arfrie22/OpenSprinkler-Hardware/KiCad/OpenSprinkler.3d/SUPERCAP_SM3R3703T01.stp

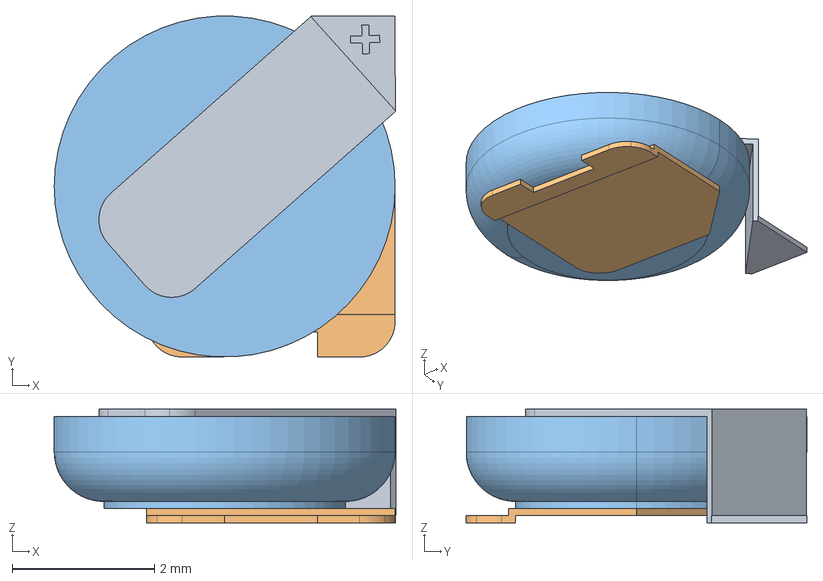
[picture p1: CAD file, 2024-08-12]
KiCad/OpenSprinkler.3d/SUPERCAP_SM3R3703T01.stp
4.81 x 4.80 x 1.60 mm
SUPERCAP_SM3R3703T01
