arfrie22/OpenSprinkler-Hardware/KiCad/RP2350_QFN80.step

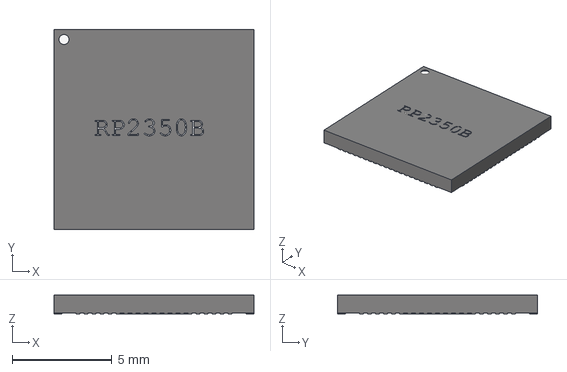
[picture p2: CAD file, 2025-09-04]
KiCad/RP2350_QFN80.step
10.0 x 10.0 x 0.95 mm
