arfrie22/OpenSprinkler-Hardware/KiCad/OpenSprinkler.3d/HRO_TYPE-C-31-M-12.step

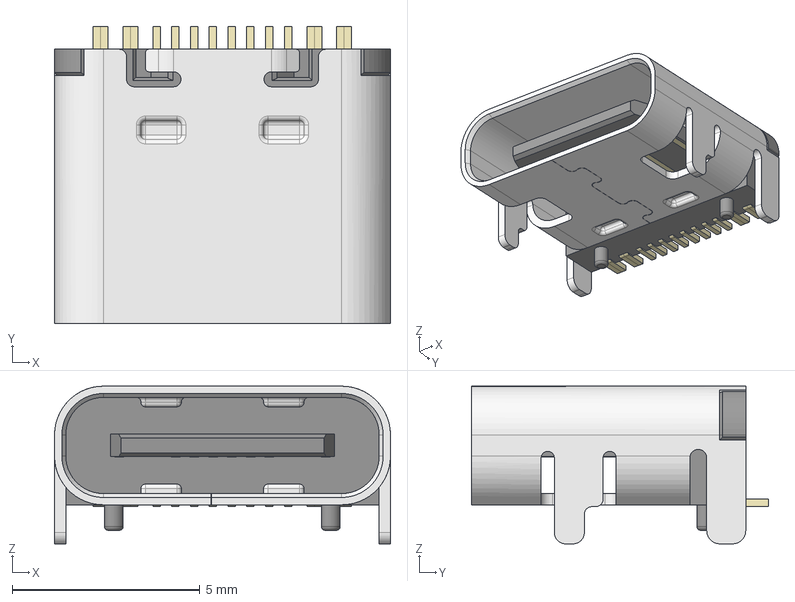
[picture p3: CAD file, 2024-08-12]
KiCad/OpenSprinkler.3d/HRO_TYPE-C-31-M-12.step
8.95 x 7.90 x 4.20 mm
