arfrie22/OpenSprinkler-Hardware/OS/4.0/OpenSprinkler4.0_DC/out/OpenSprinkler4.0_DC.pdf

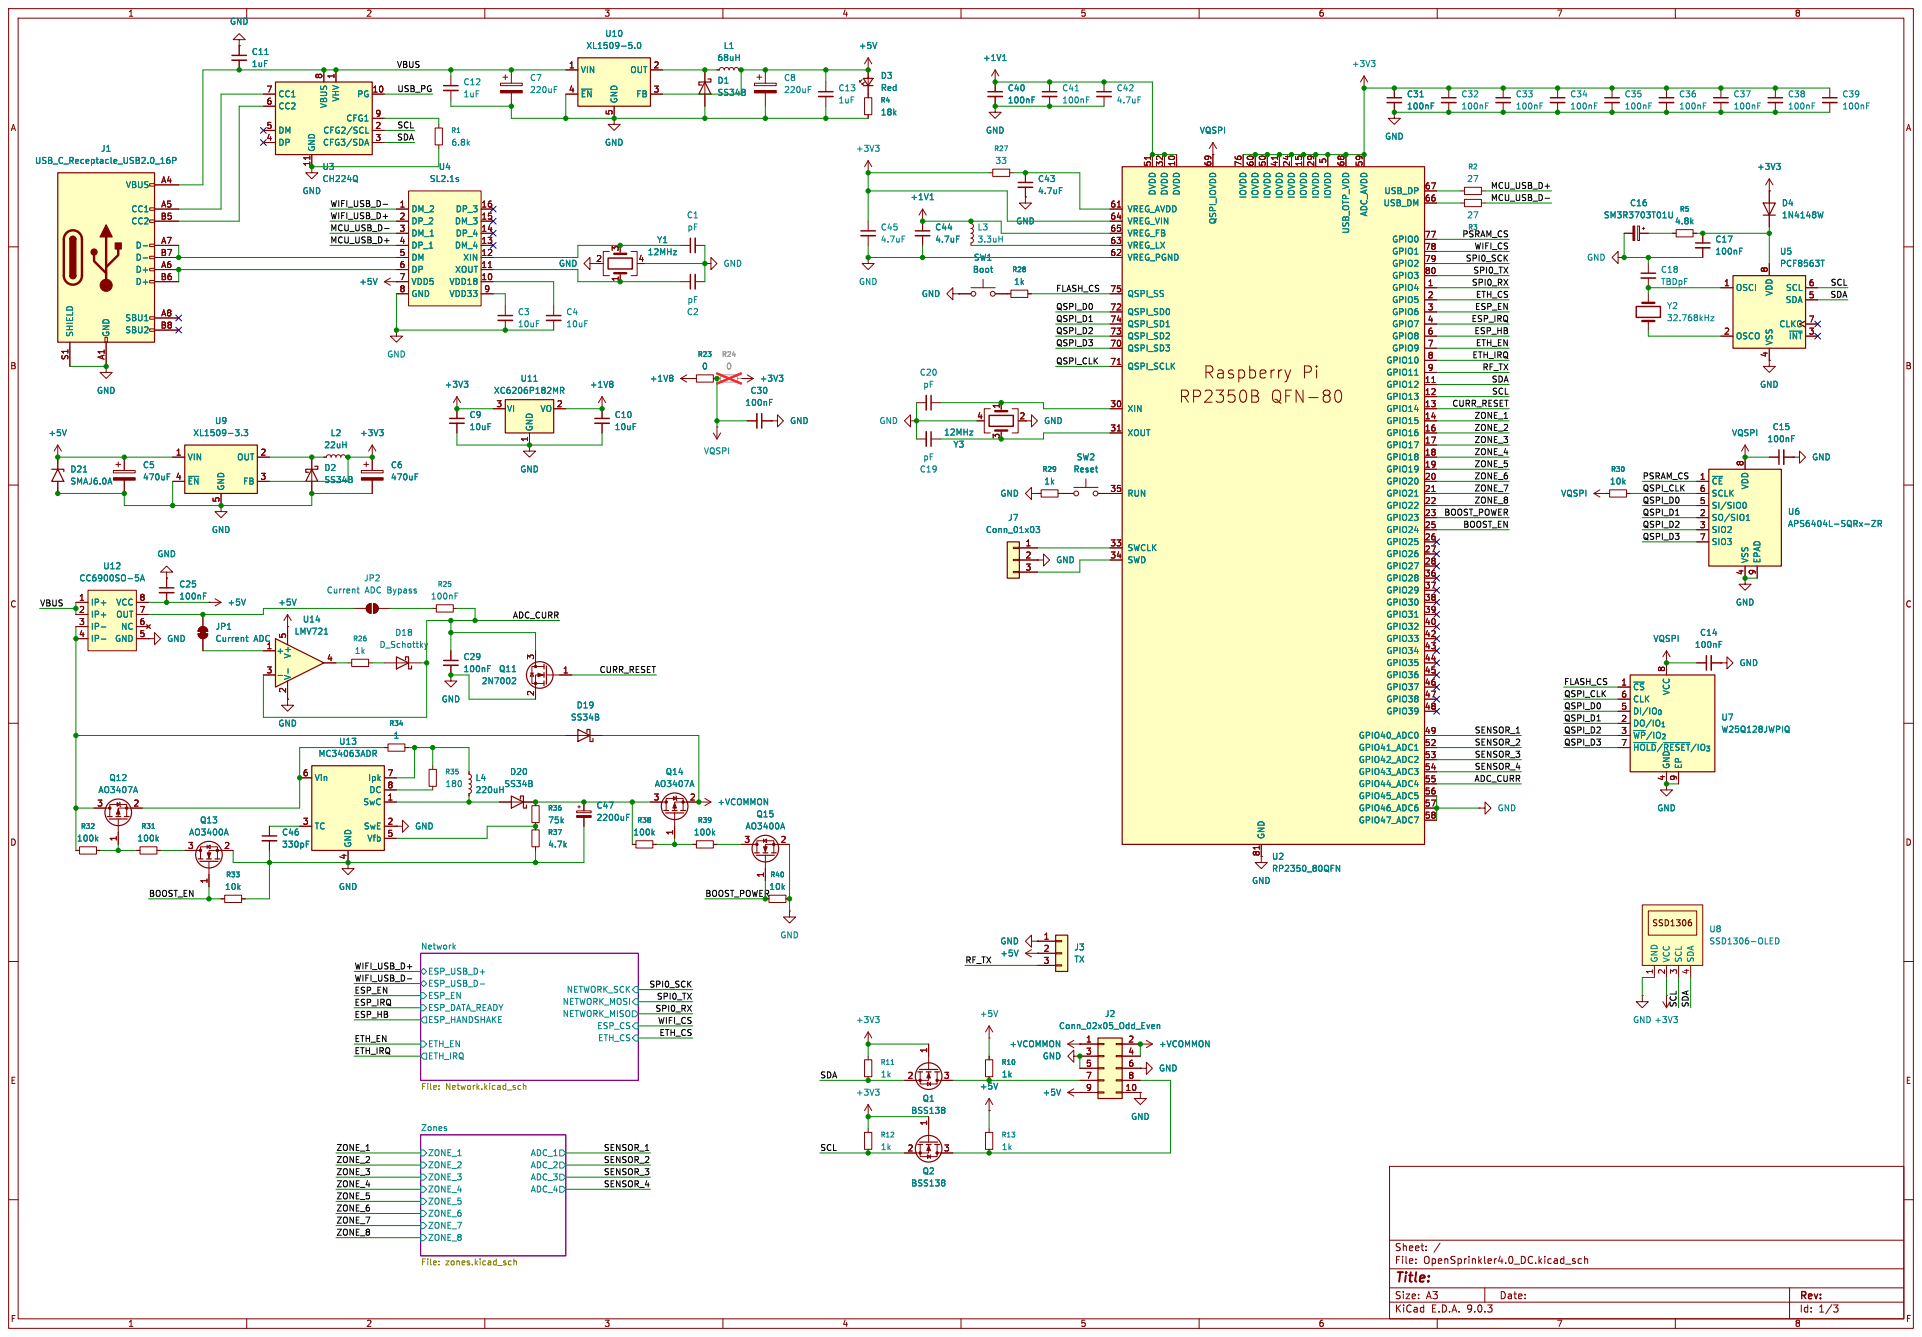
[picture p4: page 1]

1 PG 10 CFG1 9 CFG2/SCL 2 CFG3/SDA 3 GND

Id: 1/3 Title: File: OpenSprinkler4.0_DC.kicad_sch Sheet: / ADC_1 ADC_2 ADC_3 ADC_4 ZONE_1 ZONE_2 ZONE_3 ZONE_4 ZONE_5 ZONE_6 ZONE_7 ZONE_8 Zones File: zones.kicad_sch ESP_HANDSHAKE

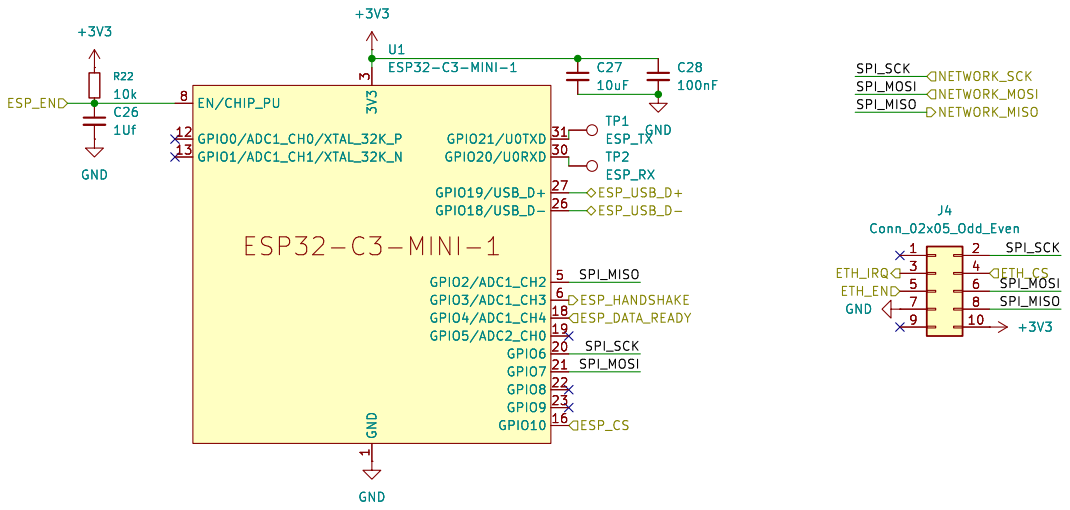
[picture p5: page 2]

Id: 2/3 Title: File: Network.kicad_sch Sheet: /Network/

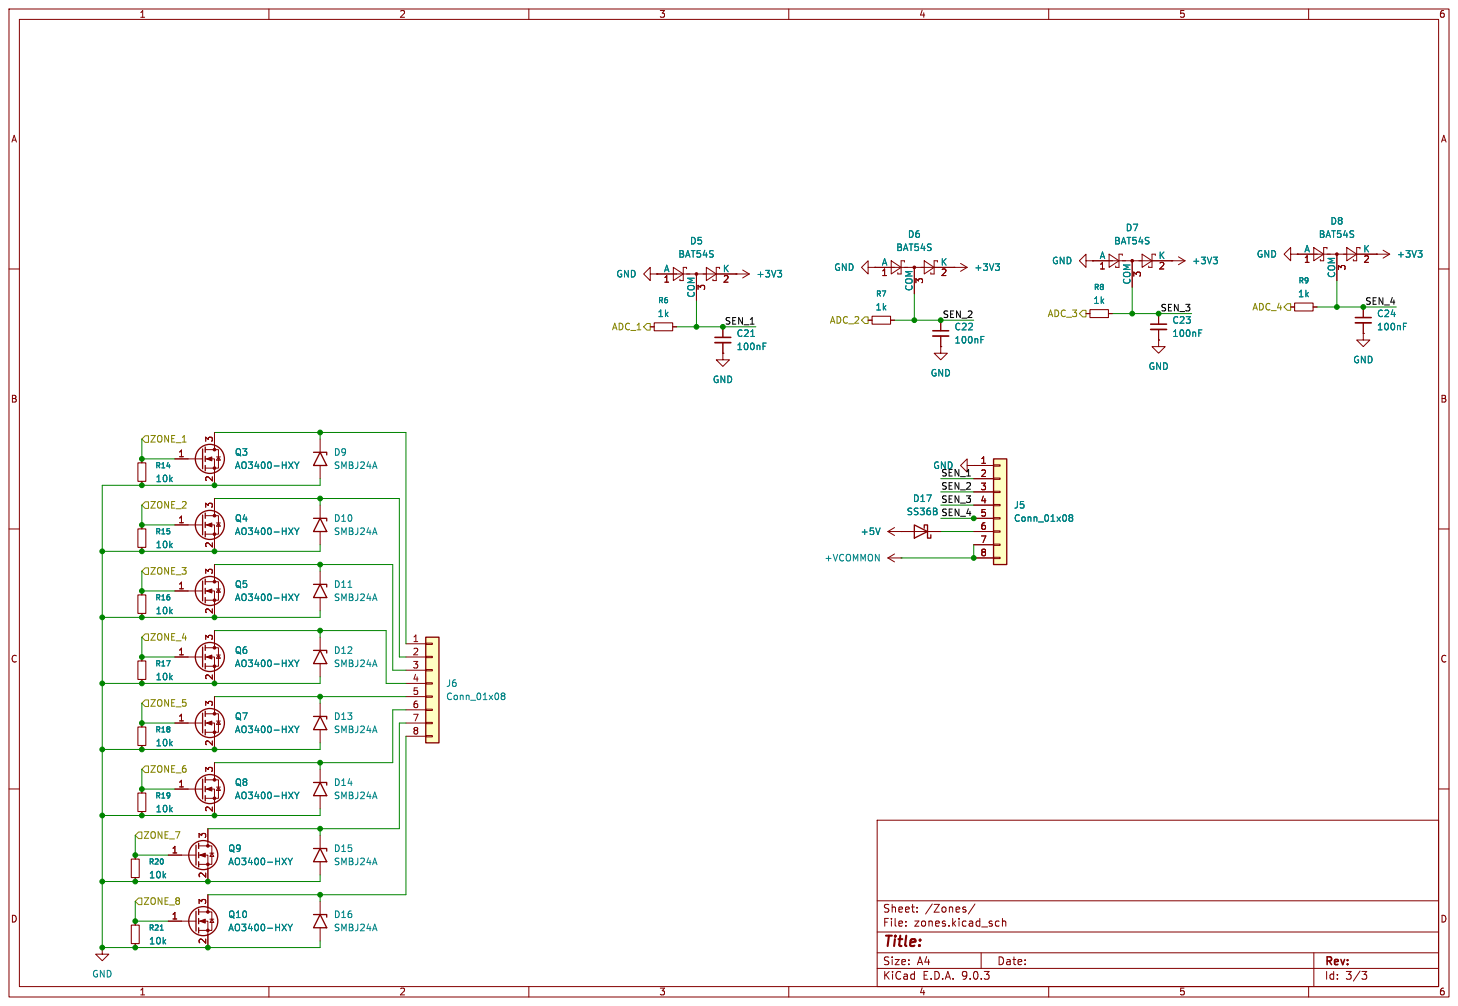
[picture p6: page 3]

Id: 3/3 Title: File: zones.kicad_sch Sheet: /Zones/
