arfrie22/OpenSprinkler-Hardware/OS/4.0/OpenSprinkler4.0_DC/OpenSprinkler4.0_DC.kicad_pcb

## KiCad design OS/4.0/OpenSprinkler4.0_DC/OpenSprinkler4.0_DC.kicad_pcb (2025-09-04)

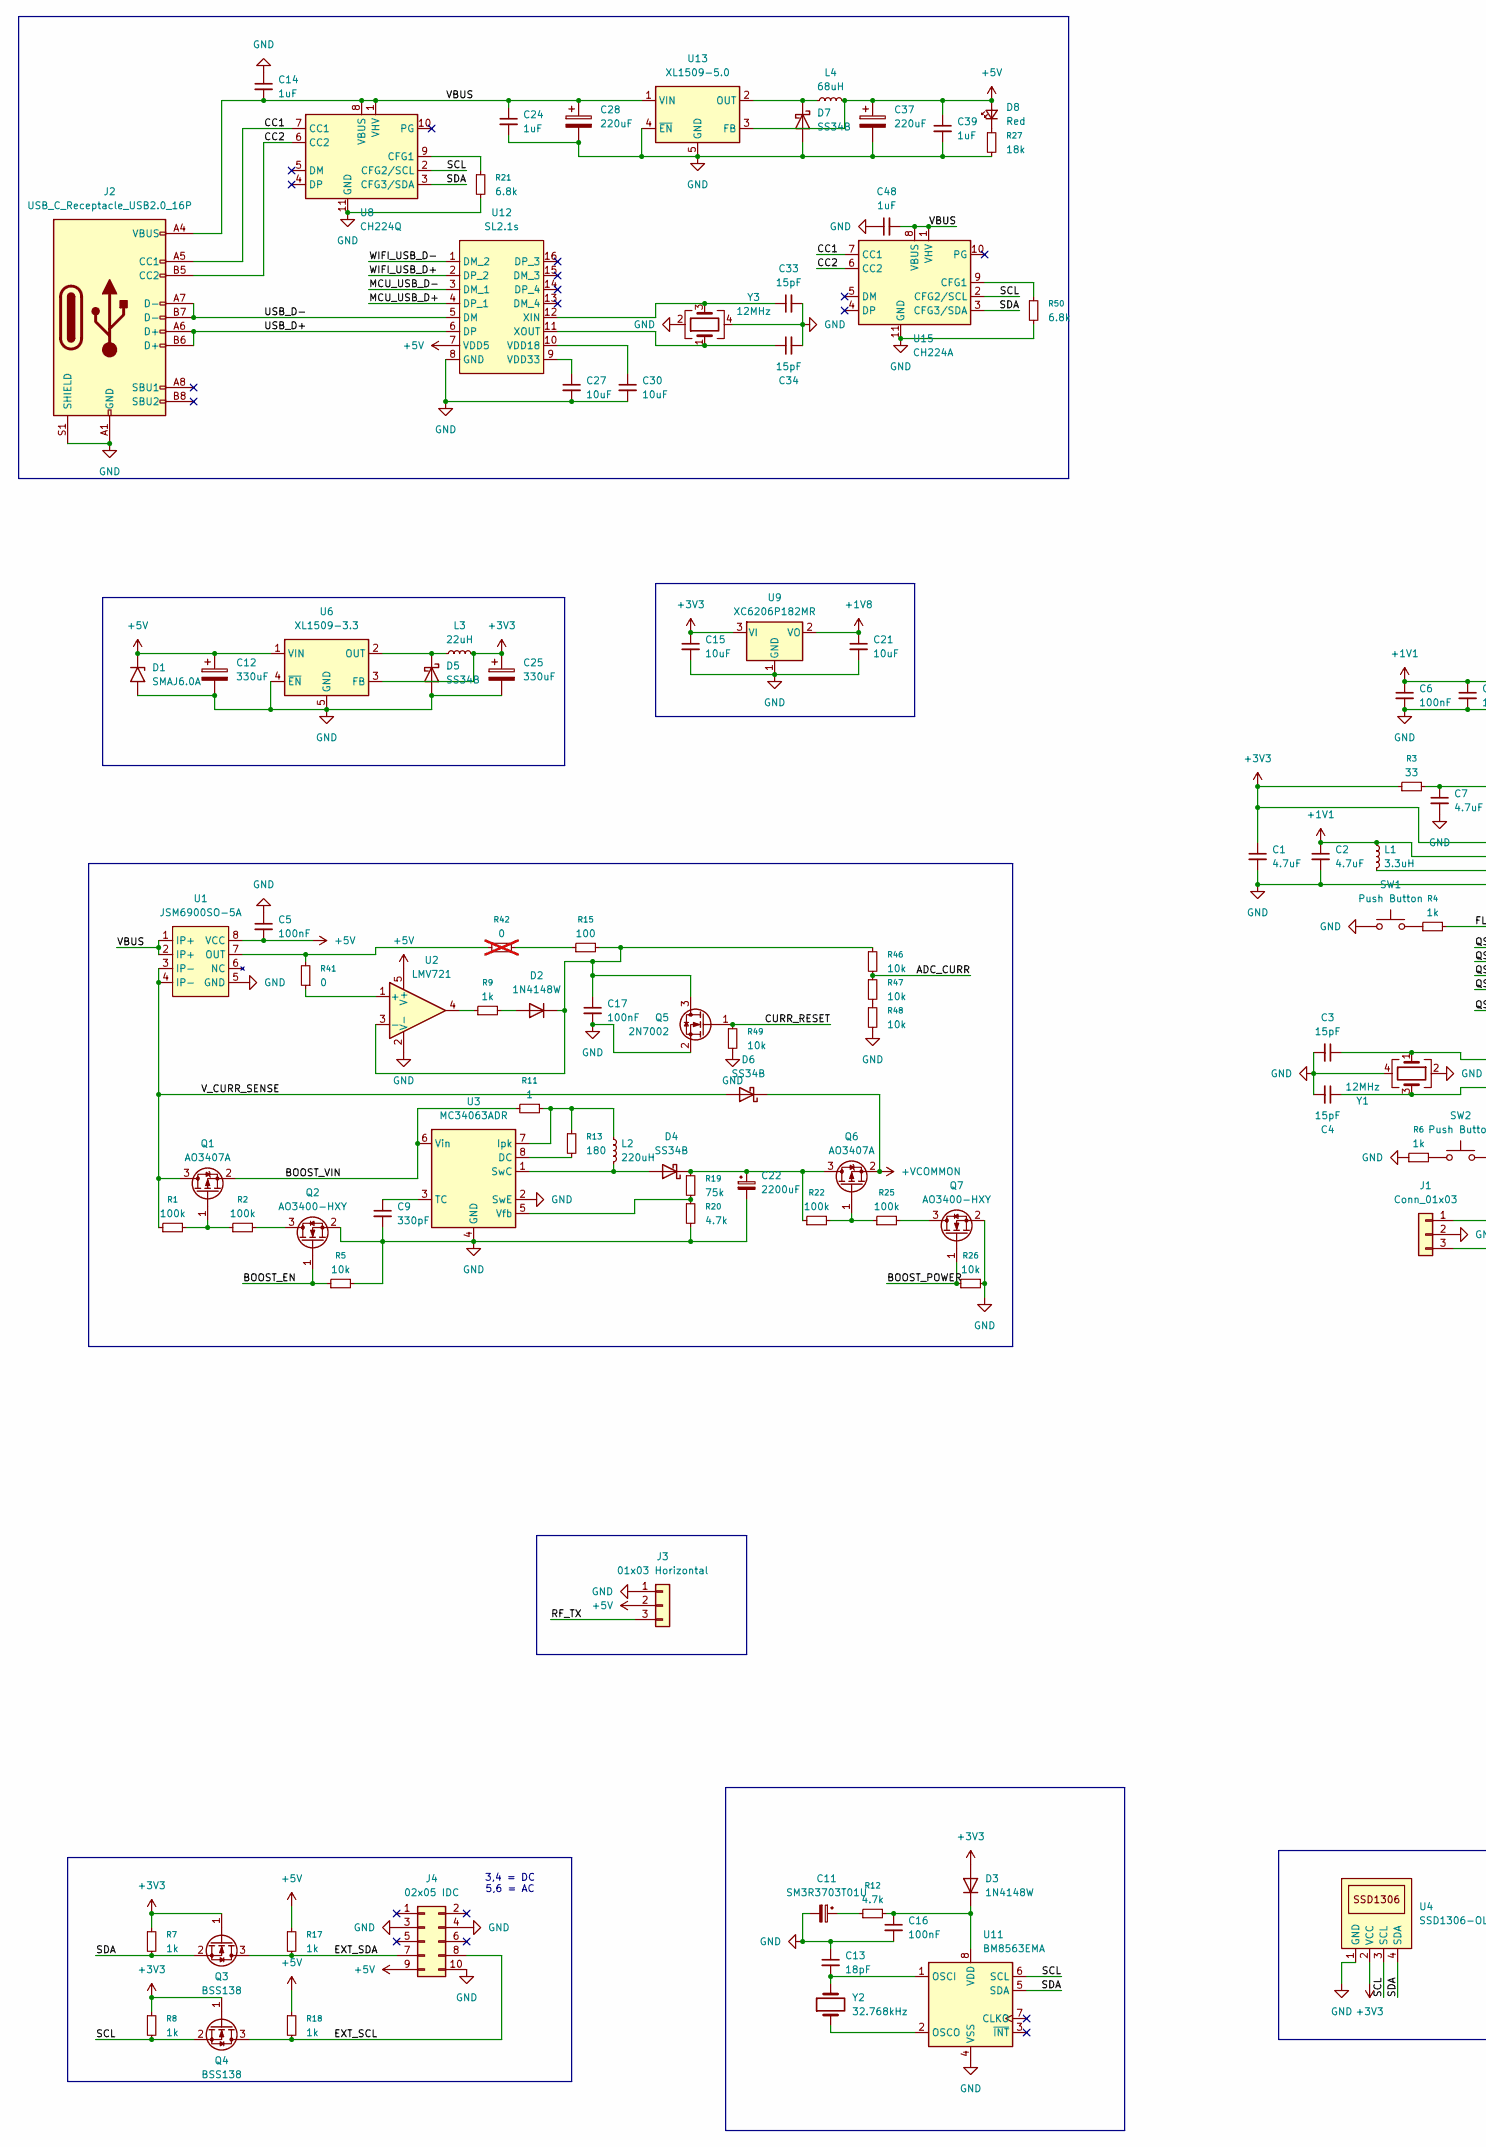
[picture p7: schematic OpenSprinkler4.0_DC.kicad_sch, part in row 1, column 1]

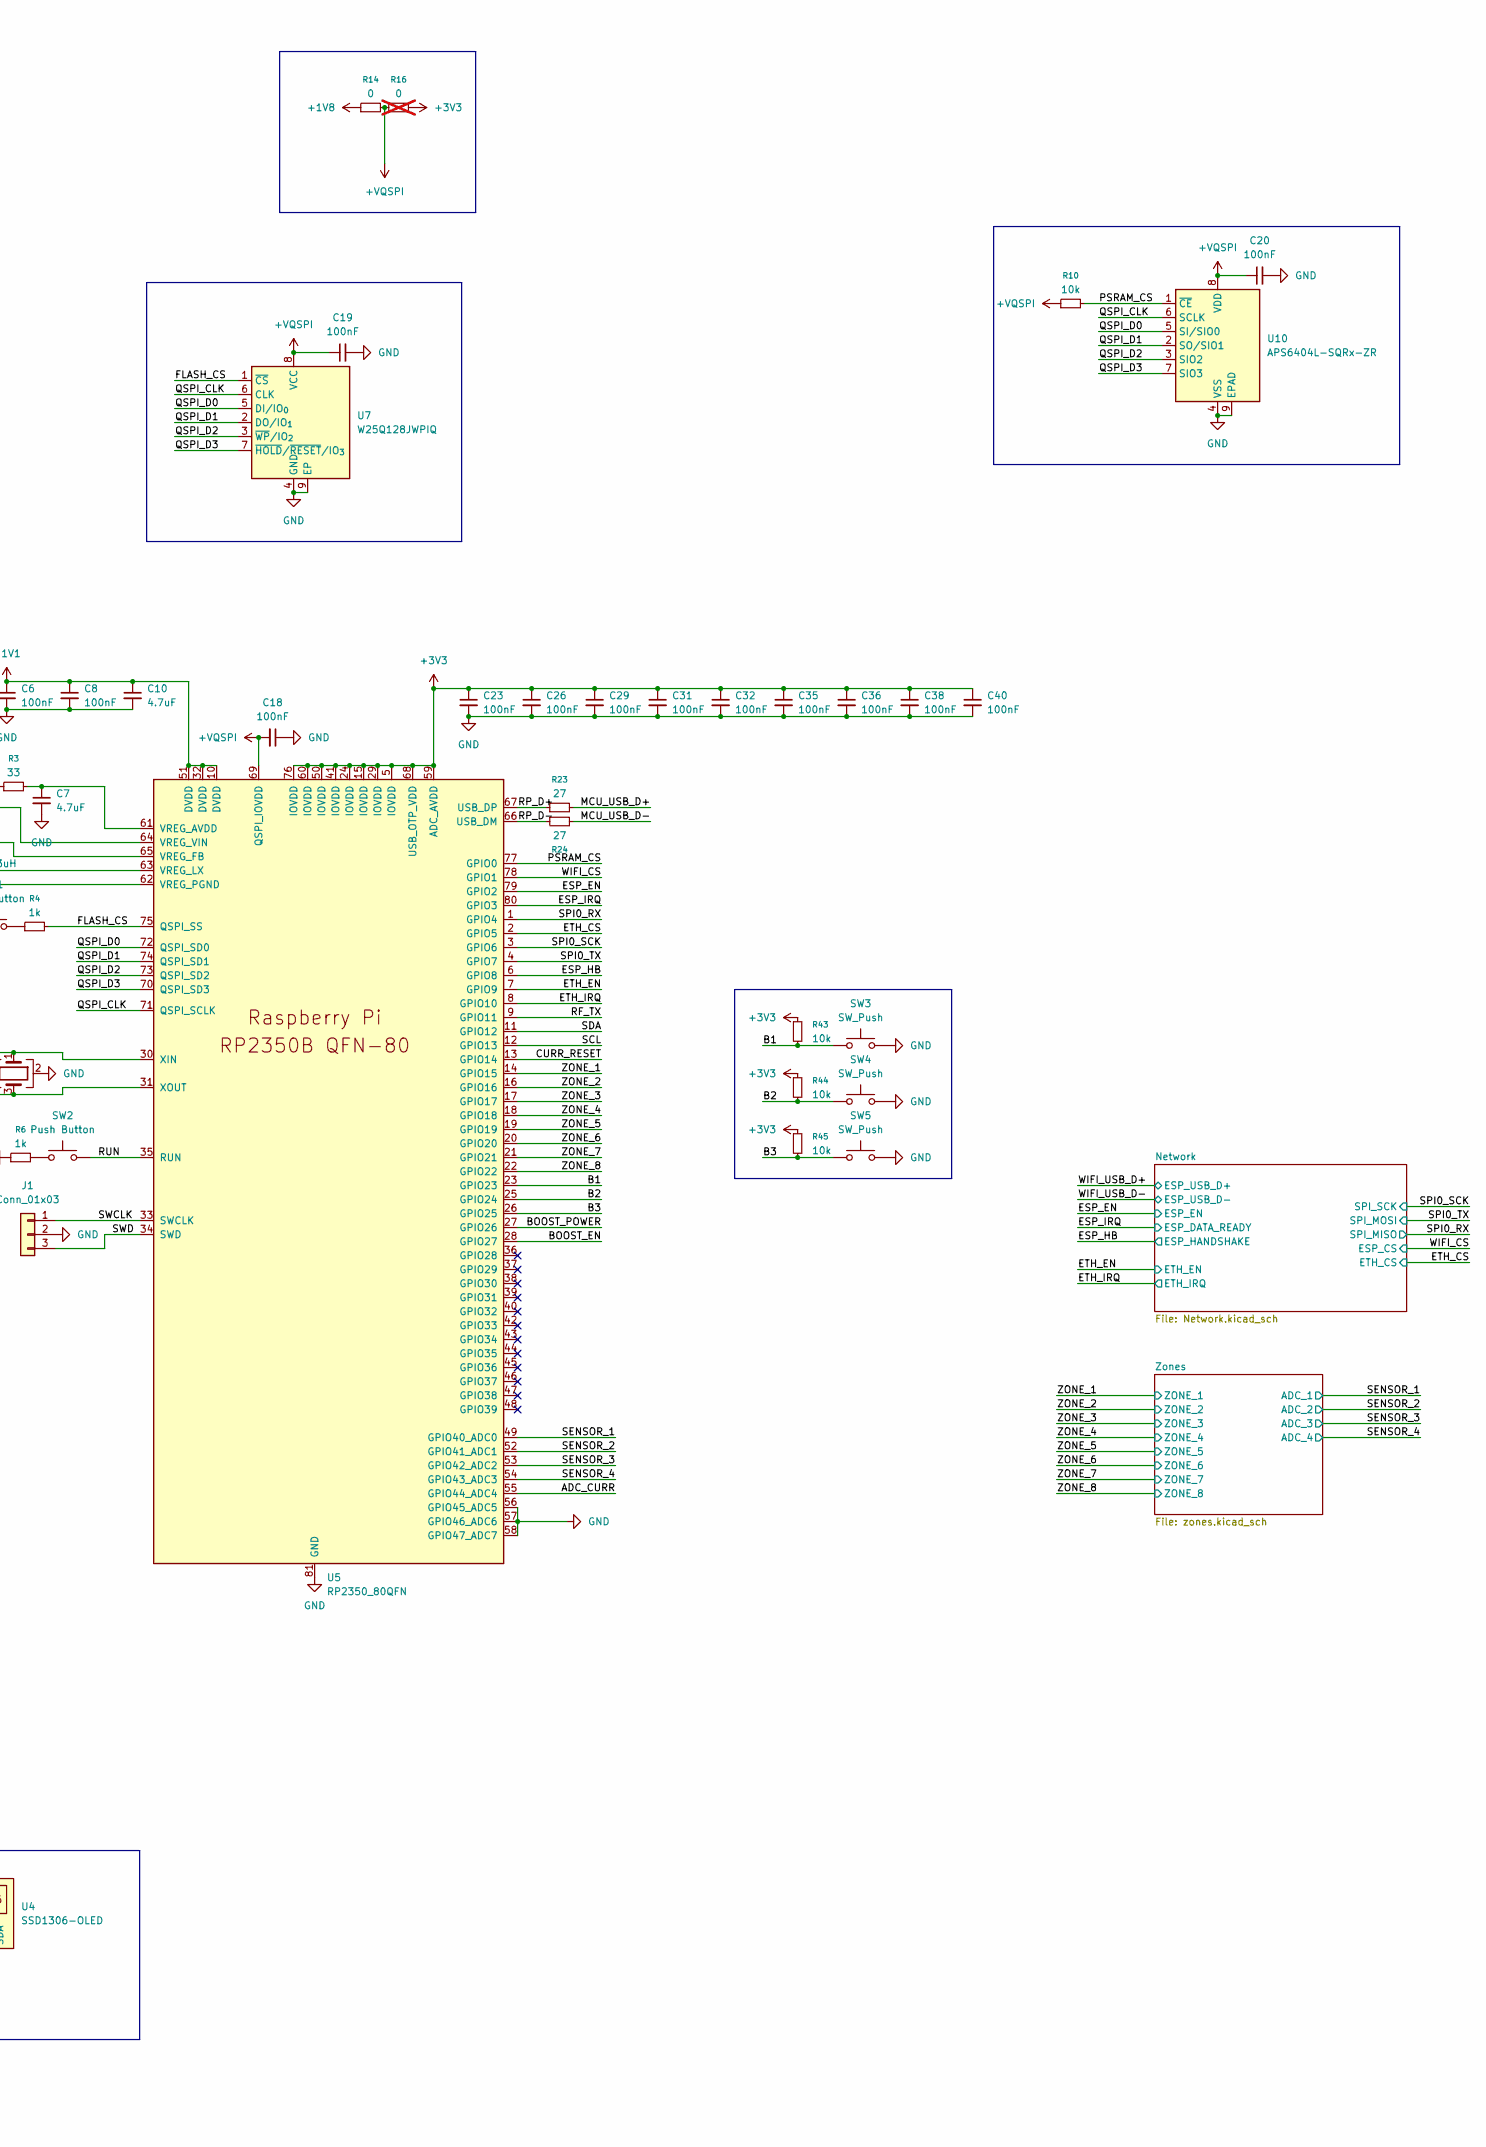
[picture p8: schematic OpenSprinkler4.0_DC.kicad_sch, part in row 1, column 2]

Parts:
C1, C2, C7, C10: 4.7uF; C_0402_1005Metric; LCSC C23733
C3, C4, C33, C34: 15pF; C_0402_1005Metric; LCSC C1548
C5, C6, C8, C16, C17, C18, C19, C20, C23, C26, C29, C31, C32, C35, C36, C38, C40: 100nF; C_0402_1005Metric; LCSC C307331
C9: 330pF; C_0402_1005Metric; LCSC C13533
C11: SM3R3703T01U; SM3R3703T01
C12, C25: 330uF; CP_Radial_D8.0mm_P3.50mm; LCSC C43839
C13: 18pF; C_0402_1005Metric; LCSC C1549
C14, C24, C39, C48: 1uF; C_0603_1608Metric; LCSC C15849
C15, C21, C27, C30: 10uF; C_0603_1608Metric; LCSC C19702
C22: 2200uF; CP_Radial_L20.0mm_D13.0mm_P5.00mm_Horizontal; LCSC C44598
C28, C37: 220uF; CP_Radial_D6.3mm_P2.50mm; LCSC C12450
D1: SMAJ6.0A; D_SMA; LCSC C19077525
D2, D3: 1N4148W; D_SOD-123; LCSC C7420318
D4, D5, D6, D7: SS34B; D_SMB; LCSC C7420366
D8: Red; LED_0603_1608Metric; LCSC C2286
J1: Conn_01x03; JST_XH_B3B-XH-A_1x03_P2.50mm_Vertical; LCSC C144394
J2: USB_C_Receptacle_USB2.0_16P; USB_C_Receptacle_HRO_TYPE-C-31-M-12; LCSC C2927038
J3: 01x03 Horizontal; PinSocket_1x03_P2.54mm_Horizontal; LCSC C2935993
J4: 02x05 IDC; IDC-Header_2x05_P2.54mm_Horizontal; LCSC C9140
L1: 3.3uH; L_Murata_DFE201610P; LCSC C42411119
L2: 220uH; L_Changjiang_FNR8040S; LCSC C168148
L3: 22uH; L_Changjiang_FNR6045S; LCSC C168080
L4: 68uH; L_Changjiang_FNR6045S; LCSC C168091
Q1, Q6: AO3407A; SOT-23; LCSC C3033400
Q2, Q7: AO3400-HXY; SOT-23; LCSC C4748804
Q3, Q4: BSS138; SOT-23; LCSC C7420339
Q5: 2N7002; SOT-23; LCSC C8545
R1, R2, R22, R25: 100k; R_0402_1005Metric; LCSC C25741
R3: 33; R_0402_1005Metric; LCSC C25105
R4, R6, R7, R8, R9, R17, R18: 1k; R_0402_1005Metric; LCSC C11702
R5, R10, R26, R43, R44, R45, R46, R47, R48, R49: 10k; R_0402_1005Metric; LCSC C25744
R11: 1; R_0603_1608Metric; LCSC C22936
R12, R20: 4.7k; R_0402_1005Metric; LCSC C25900
R13: 180; R_0603_1608Metric; LCSC C22828
R14, R41: 0; R_0402_1005Metric; LCSC C17168
R15: 100; R_0402_1005Metric; LCSC C25076
R16, R42: 0; R_0402_1005Metric; LCSC C17168; not fitted
R19: 75k; R_0402_1005Metric; LCSC C25798
R21, R50: 6.8k; R_0402_1005Metric; LCSC C25917
R23, R24: 27; R_0402_1005Metric; LCSC C25100
R27: 18k; R_0402_1005Metric; LCSC C25762
SW1, SW2: Push Button; SW_SPST_SKQG_WithoutStem; LCSC C318884
SW3, SW4, SW5: SW_Push; SW_Tactile_SPST_Angled_PTS645Vx83-2LFS; LCSC C493019
U1: JSM6900SO-5A; SSOP-8_3.9x5.05mm_P1.27mm; LCSC C7496525
U2: LMV721; SOT-23-5; LCSC C20613263
U3: MC34063ADR; SOP-8_3.76x4.96mm_P1.27mm; LCSC C3014308
U4: SSD1306-OLED; JMD0.96D-1
U5: RP2350_80QFN; QFN-80-1EP_10x10mm_P0.4mm_EP3.4x3.4mm; LCSC C42415655
U6: XL1509-3.3; SOIC-8_3.9x4.9mm_P1.27mm; LCSC C2681226
U7: W25Q128JWPIQ; WSON-8-1EP_6x5mm_P1.27mm_EP3.4x4.3mm; LCSC C2689660
U8: CH224Q; Texas_DLH0010A_WSON-10-1EP_2.2x2mm_P0.4mm_EP0.9x1.5mm; LCSC C46061833
U9: XC6206P182MR; SOT-23-3; LCSC C347373
U10: APS6404L-SQRx-ZR; Winbond_USON-8-1EP_3x2mm_P0.5mm_EP0.2x1.6mm; LCSC C43758152
U11: BM8563EMA; SOIC-8_3.9x4.9mm_P1.27mm; LCSC C269878
U12: SL2.1s; SL2.1S; LCSC C2684433
U13: XL1509-5.0; SOIC-8_3.9x4.9mm_P1.27mm; LCSC C2902368
U15: CH224A; SSOP-10-1EP_3.9x4.9mm_P1mm_EP2.1x3.3mm; LCSC C42459160
Y1, Y3: 12MHz; Crystal_SMD_2520-4Pin_2.5x2.0mm; LCSC C7294610
Y2: 32.768kHz; Crystal_SMD_3215-2Pin_3.2x1.5mm; LCSC C32346

Connections:
+1V1: C2.1, C6.1, C8.1, C10.1, L1.1, U5.10 (DVDD), U5.32 (DVDD), U5.51 (DVDD), U5.65 (VREG_FB)
+1V8: C21.1, R14.1, U9.2 (VO)
+3V3: C1.1, C15.1, C23.1, C25.1, C26.1, C29.1, C31.1, C32.1, C35.1, C36.1, C38.1, C40.1, D3.2 (A), L3.2, Q3.1 (G), Q4.1 (G), R3.1, R7.1, R8.1, R16.2, R43.1, R44.1, R45.1, U4.2 (VCC), U5.5 (IOVDD), U5.15 (IOVDD), U5.24 (IOVDD), U5.29 (IOVDD), U5.41 (IOVDD), U5.50 (IOVDD), U5.59 (ADC_AVDD), U5.60 (IOVDD), U5.64 (VREG_VIN), U5.68 (USB_OTP_VDD), U5.76 (IOVDD), U6.3 (FB), U9.3 (VI); also elsewhere on the board
+5V: C5.2, C12.1, C37.1, C39.1, D1.1 (A1), D8.2 (A), J3.2, J4.9, L4.2, R17.1, R18.1, U1.8 (VCC), U2.5 (V+), U6.1 (VIN), U12.7 (VDD5), U13.3 (FB); also elsewhere on the board
+VQSPI: C18.2, C19.1, C20.1, R10.1, R14.2, R16.1, U5.69 (QSPI_IOVDD), U7.8 (VCC), U10.8 (VDD)
/ADC_CURR: R46.2, R47.1, U5.55 (GPIO44_ADC4)
/B1: R43.2, SW3.1, U5.23 (GPIO23)
/B2: R44.2, SW4.1, U5.25 (GPIO24)
/B3: R45.2, SW5.1, U5.26 (GPIO25)
/BOOST_EN: Q2.1 (G), R5.1, U5.28 (GPIO27)
/BOOST_POWER: Q7.1 (G), R26.1, U5.27 (GPIO26)
/BOOST_VIN: Q1.2 (S), R11.2, U3.6 (Vin)
/CC1: J2.A5 (CC1), U8.7 (CC1), U15.7 (CC1)
/CC2: J2.B5 (CC2), U8.6 (CC2), U15.6 (CC2)
/CURR_RESET: Q5.1 (G), R49.1, U5.13 (GPIO14)
/ESP_EN: U5.79 (GPIO2); also elsewhere on the board
/ESP_HB: U5.6 (GPIO8); also elsewhere on the board
/ESP_IRQ: U5.80 (GPIO3); also elsewhere on the board
/ETH_CS: U5.2 (GPIO5); also elsewhere on the board
/ETH_EN: U5.7 (GPIO9); also elsewhere on the board
/ETH_IRQ: U5.8 (GPIO10); also elsewhere on the board
/EXT_SCL: J4.8, Q4.3 (D), R18.2
/EXT_SDA: J4.7, Q3.3 (D), R17.2
/FLASH_CS: R4.2, U5.75 (QSPI_SS), U7.1 (~CS)
/MCU_USB_D+: R23.2, U12.4 (DP_1)
/MCU_USB_D-: R24.2, U12.3 (DM_1)
/PSRAM_CS: R10.2, U5.77 (GPIO0), U10.1 (~CE)
/QSPI_CLK: U5.71 (QSPI_SCLK), U7.6 (CLK), U10.6 (SCLK)
/QSPI_D0: U5.72 (QSPI_SD0), U7.5 (DI/IO_{0}), U10.5 (SI/SIO0)
/QSPI_D1: U5.74 (QSPI_SD1), U7.2 (DO/IO_{1}), U10.2 (SO/SIO1)
/QSPI_D2: U5.73 (QSPI_SD2), U7.3 (~WP/IO_{2}), U10.3 (SIO2)
/QSPI_D3: U5.70 (QSPI_SD3), U7.7 (~HOLD/~RESET/IO_{3}), U10.7 (SIO3)
/RF_TX: J3.3, U5.9 (GPIO11)
/RP_D+: R23.1, U5.67 (USB_DP)
/RP_D-: R24.1, U5.66 (USB_DM)
/RUN: SW2.2, U5.35 (RUN)
/SCL: Q4.2 (S), R8.2, U4.3 (SCL), U5.12 (GPIO13), U8.2 (CFG2/SCL), U11.6 (SCL), U15.2 (CFG2/SCL)
/SDA: Q3.2 (S), R7.2, U4.4 (SDA), U5.11 (GPIO12), U8.3 (CFG3/SDA), U11.5 (SDA), U15.3 (CFG3/SDA)
/SENSOR_1: U5.49 (GPIO40_ADC0); also elsewhere on the board
/SENSOR_2: U5.52 (GPIO41_ADC1); also elsewhere on the board
/SENSOR_3: U5.53 (GPIO42_ADC2); also elsewhere on the board
/SENSOR_4: U5.54 (GPIO43_ADC3); also elsewhere on the board
/SPI0_RX: U5.1 (GPIO4); also elsewhere on the board
/SPI0_SCK: U5.3 (GPIO6); also elsewhere on the board
/SPI0_TX: U5.4 (GPIO7); also elsewhere on the board
/SWCLK: J1.1, U5.33 (SWCLK)
/SWD: J1.3, U5.34 (SWD)
/USB_D+: J2.A6 (D+), J2.B6 (D+), U12.6 (DP)
/USB_D-: J2.A7 (D-), J2.B7 (D-), U12.5 (DM)
/VBUS: C14.2, C24.1, C28.1, C48.2, J2.A4 (VBUS), J2.A9 (VBUS), J2.B4 (VBUS), J2.B9 (VBUS), U1.1 (IP+), U1.2 (IP+), U8.1 (VHV), U8.8 (VBUS), U13.1 (VIN), U15.1 (VHV), U15.8 (VBUS)
/V_CURR_SENSE: D6.2 (A), Q1.3 (D), R1.1, U1.3 (IP-), U1.4 (IP-)
/WIFI_CS: U5.78 (GPIO1); also elsewhere on the board
/WIFI_USB_D+: U12.2 (DP_2); also elsewhere on the board
/WIFI_USB_D-: U12.1 (DM_2); also elsewhere on the board
/ZONE_1: U5.14 (GPIO15); also elsewhere on the board
/ZONE_2: U5.16 (GPIO16); also elsewhere on the board
/ZONE_3: U5.17 (GPIO17); also elsewhere on the board
/ZONE_4: U5.18 (GPIO18); also elsewhere on the board
/ZONE_5: U5.19 (GPIO19); also elsewhere on the board
/ZONE_6: U5.20 (GPIO20); also elsewhere on the board
/ZONE_7: U5.21 (GPIO21); also elsewhere on the board
/ZONE_8: U5.22 (GPIO22); also elsewhere on the board
unnamed: C11.1, R12.1
unnamed: D2.2 (A), R9.2
unnamed: C17.1, D2.1 (K), Q5.3 (D), R15.2, R46.1, U2.3 (-)
unnamed: C16.1, D3.1 (K), R12.2, U11.8 (VDD)
unnamed: D4.2 (A), L2.2, U3.1 (SwC)
unnamed: C22.1, D4.1 (K), Q6.3 (D), R19.1, R22.1
unnamed: D5.1 (K), L3.1, U6.2 (OUT)
unnamed: D7.1 (K), L4.1, U13.2 (OUT)
unnamed: D8.1 (K), R27.1
unnamed: Q1.1 (G), R1.2, R2.1
unnamed: Q2.3 (D), R2.2
unnamed: Q6.1 (G), R22.2, R25.1
unnamed: Q7.3 (D), R25.2
unnamed: R4.1, SW1.2
unnamed: R6.2, SW2.1
unnamed: R9.1, U2.4
unnamed: R15.1, R42.2
unnamed: R47.2, R48.1
unnamed: R41.2, R42.1, U1.7 (OUT)
unnamed: R41.1, U2.1 (+)
unnamed: R13.2, U3.8 (DC)
unnamed: L2.1, R11.1, R13.1, U3.7 (Ipk)
unnamed: C9.1, U3.3 (TC)
unnamed: R19.2, R20.1, U3.5 (Vfb)
unnamed: C7.1, R3.2, U5.61 (VREG_AVDD)
unnamed: L1.2, U5.63 (VREG_LX)
unnamed: C3.1, U5.30 (XIN), Y1.1
unnamed: C4.1, U5.31 (XOUT), Y1.3
unnamed: R21.1, U8.9 (CFG1)
unnamed: C13.2, U11.1 (OSCI), Y2.2
unnamed: U11.2 (OSCO), Y2.1
unnamed: C30.1, U12.10 (VDD18)
unnamed: C27.1, U12.9 (VDD33)
unnamed: C33.1, U12.12 (XIN), Y3.3
unnamed: C34.1, U12.11 (XOUT), Y3.1
unnamed: R50.1, U15.9 (CFG1)

Notes on the sheet:
3,4 = DC 5,6 = AC

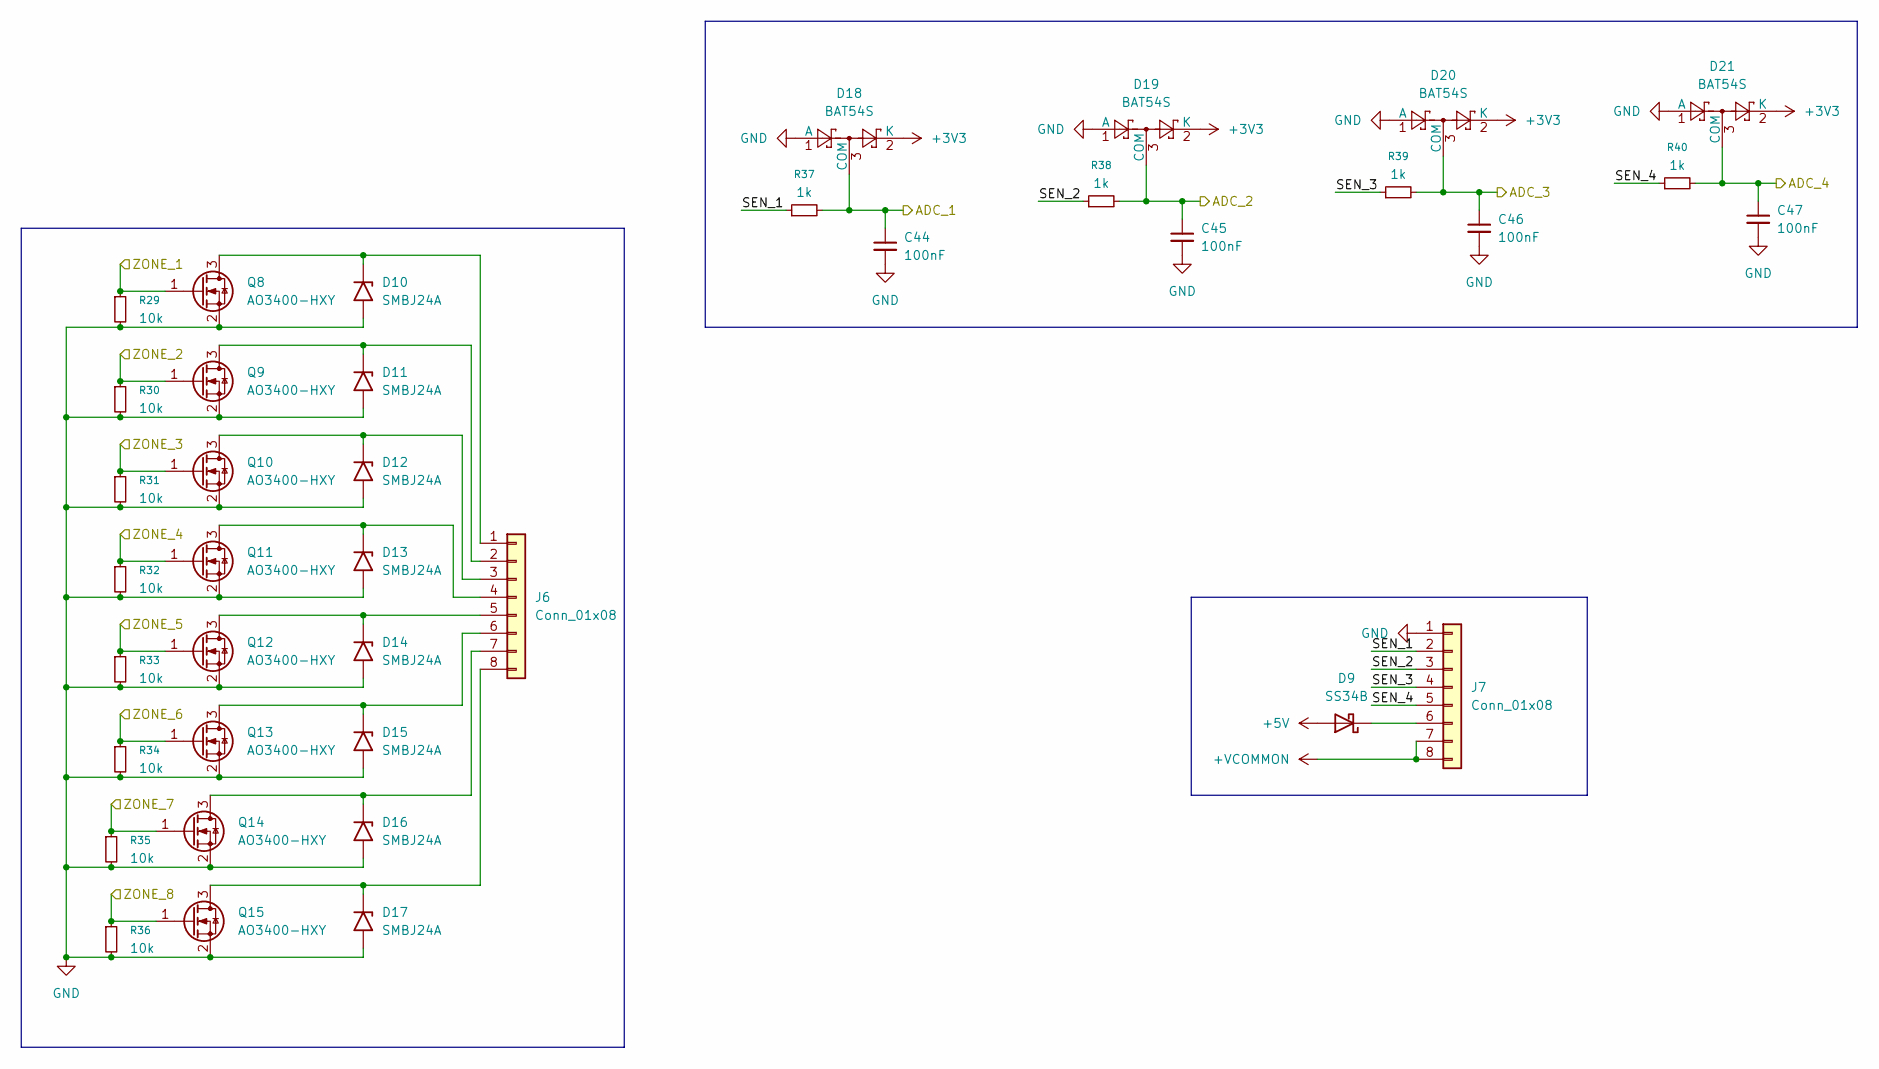
[picture p9: schematic zones.kicad_sch]

Parts:
C44, C45, C46, C47: 100nF; C_0402_1005Metric; LCSC C307331
D9: SS34B; D_SMB; LCSC C7420366
D10, D11, D12, D13, D14, D15, D16, D17: SMBJ24A; D_SMB; LCSC C19077578
D18, D19, D20, D21: BAT54S; SOT-23; LCSC C7420333
J6, J7: Conn_01x08; Samtec_HPM-08-05-x-S_Straight_1x08_Pitch5.08mm; LCSC C31423
Q8, Q9, Q10, Q11, Q12, Q13, Q14, Q15: AO3400-HXY; SOT-23; LCSC C4748804
R29, R30, R31, R32, R33, R34, R35, R36: 10k; R_0402_1005Metric; LCSC C25744
R37, R38, R39, R40: 1k; R_0402_1005Metric; LCSC C11702

Connections:
+3V3: D18.2 (K), D19.2 (K), D20.2 (K), D21.2 (K); also elsewhere on the board
+5V: D9.2 (A); also elsewhere on the board
/SENSOR_1: C44.1, D18.3 (COM), R37.2; also elsewhere on the board
/SENSOR_2: C45.1, D19.3 (COM), R38.2; also elsewhere on the board
/SENSOR_3: C46.1, D20.3 (COM), R39.2; also elsewhere on the board
/SENSOR_4: C47.1, D21.3 (COM), R40.2; also elsewhere on the board
/ZONE_1: Q8.1 (G), R29.1; also elsewhere on the board
/ZONE_2: Q9.1 (G), R30.1; also elsewhere on the board
/ZONE_3: Q10.1 (G), R31.1; also elsewhere on the board
/ZONE_4: Q11.1 (G), R32.1; also elsewhere on the board
/ZONE_5: Q12.1 (G), R33.1; also elsewhere on the board
/ZONE_6: Q13.1 (G), R34.1; also elsewhere on the board
/ZONE_7: Q14.1 (G), R35.1; also elsewhere on the board
/ZONE_8: Q15.1 (G), R36.1; also elsewhere on the board
/Zones/SEN_1: J7.2, R37.1
/Zones/SEN_2: J7.3, R38.1
/Zones/SEN_3: J7.4, R39.1
/Zones/SEN_4: J7.5, R40.1
unnamed: D9.1 (K), J7.6
unnamed: D10.1 (A1), J6.1, Q8.3 (D)
unnamed: D11.1 (A1), J6.2, Q9.3 (D)
unnamed: D12.1 (A1), J6.3, Q10.3 (D)
unnamed: D13.1 (A1), J6.4, Q11.3 (D)
unnamed: D14.1 (A1), J6.5, Q12.3 (D)
unnamed: D15.1 (A1), J6.6, Q13.3 (D)
unnamed: D16.1 (A1), J6.7, Q14.3 (D)
unnamed: D17.1 (A1), J6.8, Q15.3 (D)

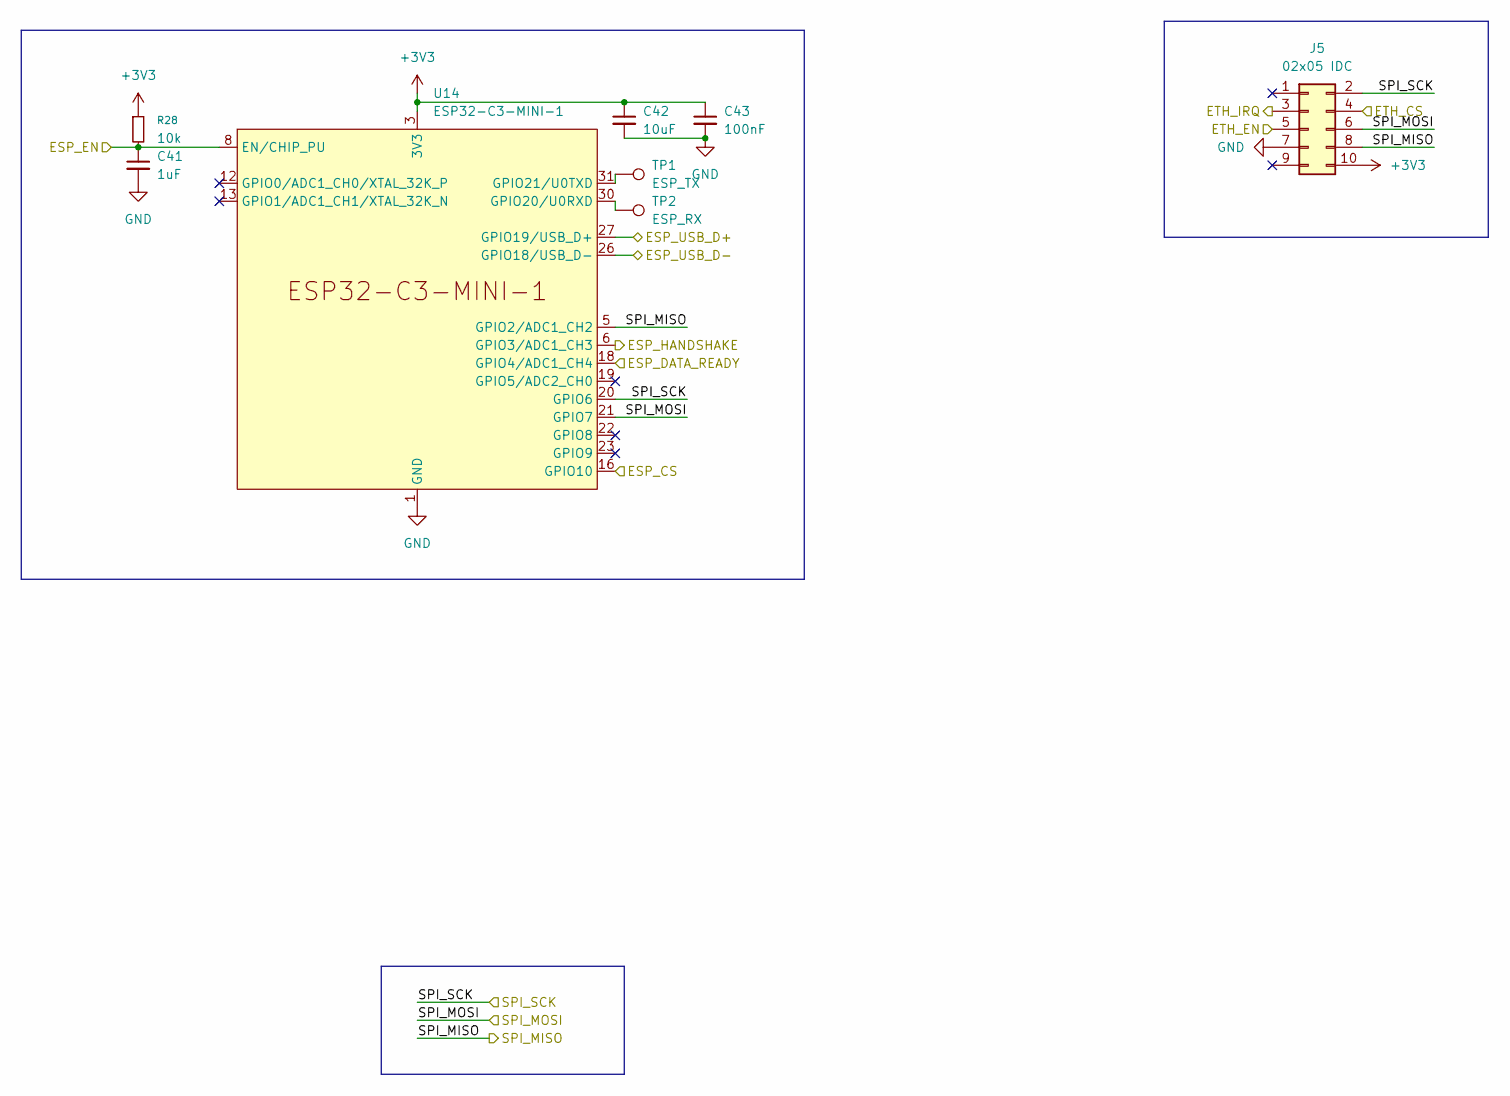
[picture p10: schematic Network.kicad_sch]

Parts:
C41: 1uF; C_0603_1608Metric; LCSC C15849
C42: 10uF; C_0603_1608Metric; LCSC C19702
C43: 100nF; C_0402_1005Metric; LCSC C307331
J5: 02x05 IDC; IDC-Header_2x05_P2.54mm_Horizontal; LCSC C9140
R28: 10k; R_0402_1005Metric; LCSC C25744
TP1: ESP_TX; TestPoint_Pad_D1.5mm
TP2: ESP_RX; TestPoint_Pad_D1.5mm
U14: ESP32-C3-MINI-1; LCSC C41349510

Connections:
+3V3: C42.1, C43.1, J5.10, R28.1, U14.3 (3V3); also elsewhere on the board
/ESP_EN: C41.1, R28.2, U14.8 (EN/CHIP_PU); also elsewhere on the board
/ESP_HB: U14.6 (GPIO3/ADC1_CH3); also elsewhere on the board
/ESP_IRQ: U14.18 (GPIO4/ADC1_CH4); also elsewhere on the board
/ETH_CS: J5.4; also elsewhere on the board
/ETH_EN: J5.5; also elsewhere on the board
/ETH_IRQ: J5.3; also elsewhere on the board
/SPI0_RX: J5.8, U14.5 (GPIO2/ADC1_CH2); also elsewhere on the board
/SPI0_SCK: J5.2, U14.20 (GPIO6); also elsewhere on the board
/SPI0_TX: J5.6, U14.21 (GPIO7); also elsewhere on the board
/WIFI_CS: U14.16 (GPIO10); also elsewhere on the board
/WIFI_USB_D+: U14.27 (GPIO19/USB_D+); also elsewhere on the board
/WIFI_USB_D-: U14.26 (GPIO18/USB_D-); also elsewhere on the board
unnamed: TP2.1, U14.30 (GPIO20/U0RXD)
unnamed: TP1.1, U14.31 (GPIO21/U0TXD)

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
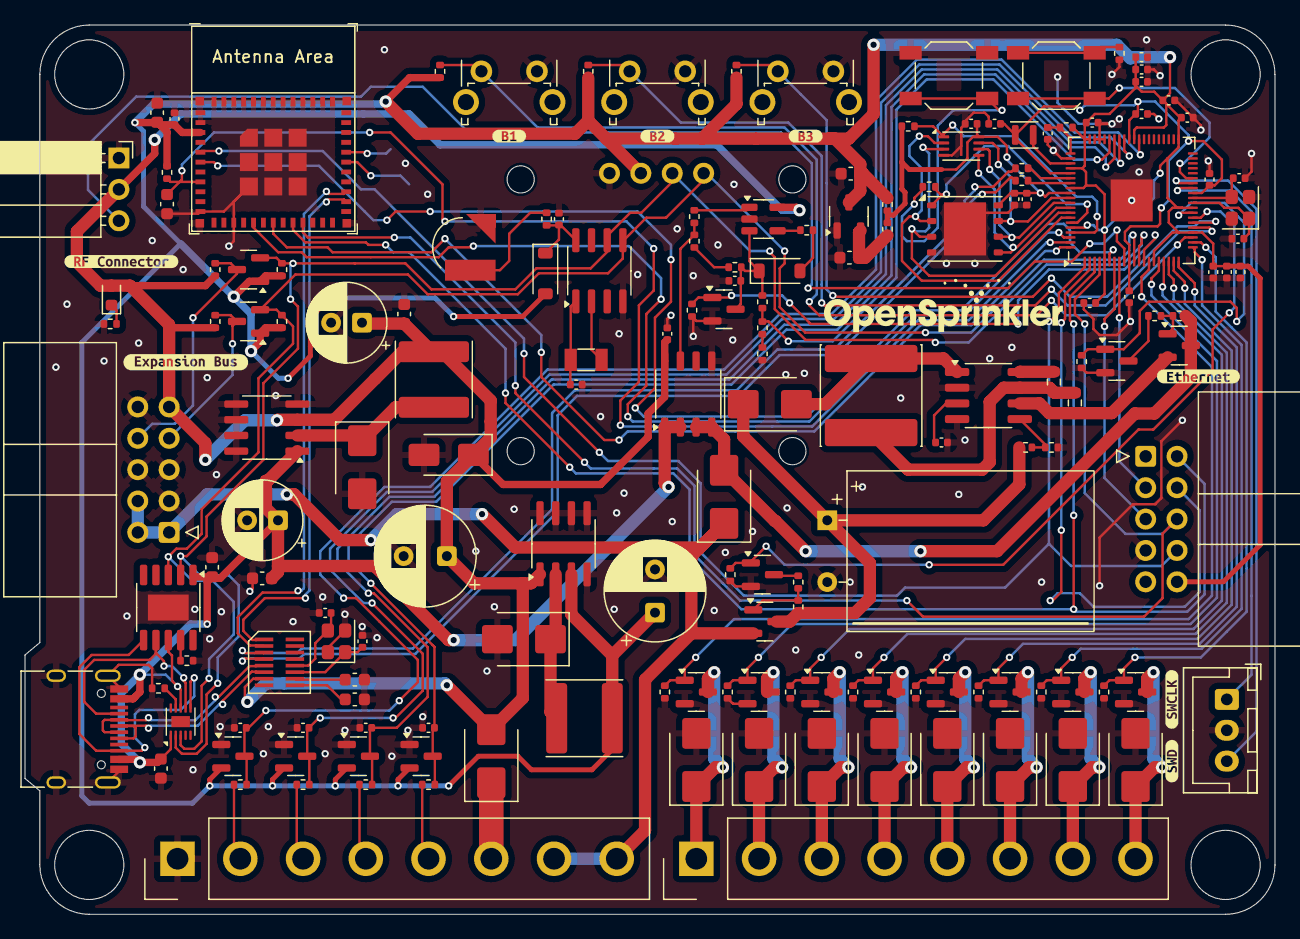
[picture p11: board OpenSprinkler4.0_DC.kicad_pcb from above]

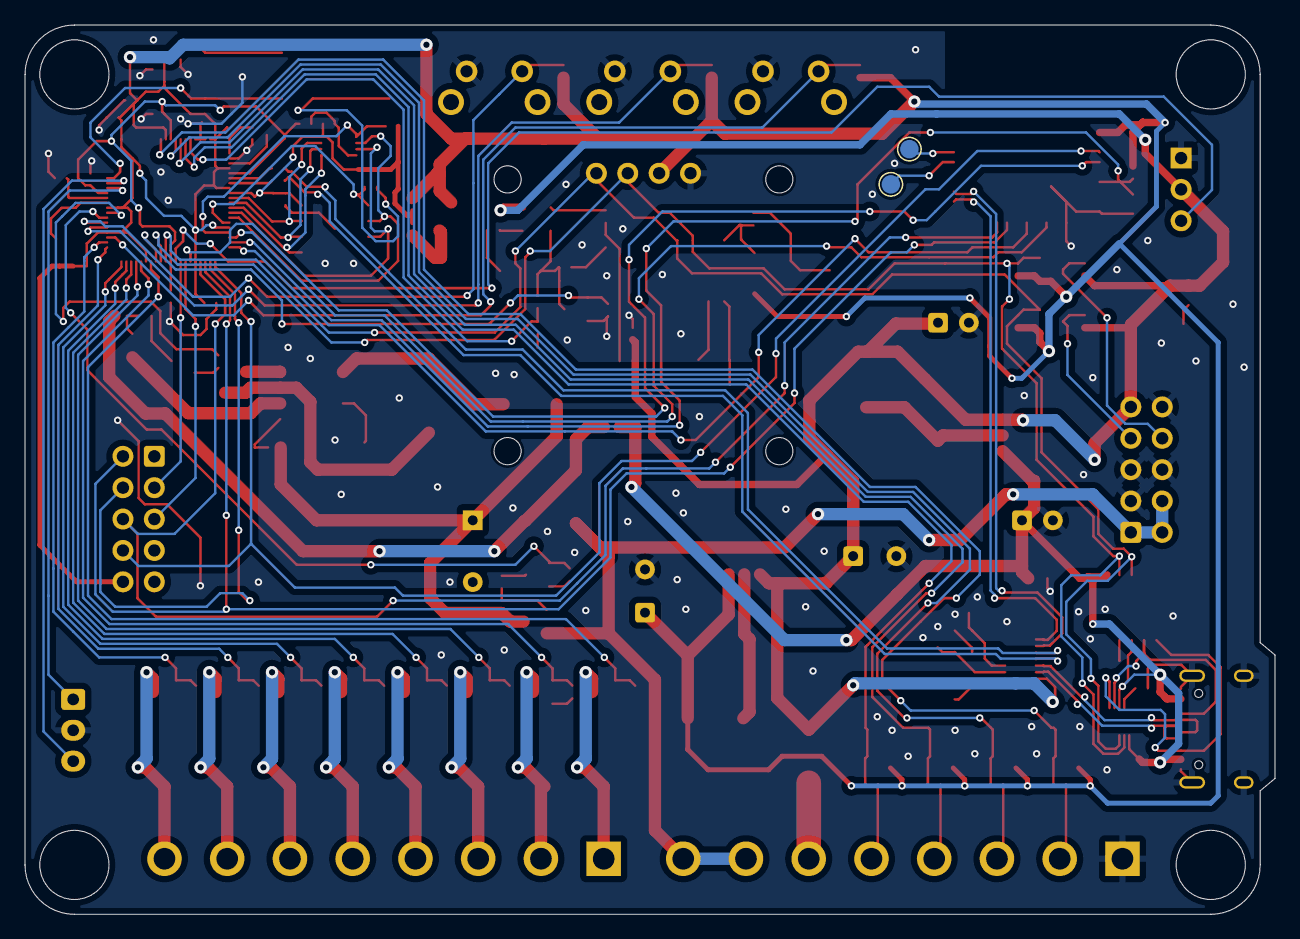
[picture p12: board OpenSprinkler4.0_DC.kicad_pcb from below]

Board: 2 copper layers, 101.2 x 72.0 mm, 178 parts (2 on the bottom side), 115 nets.

Other parts of the board:
kibuzzard-688CCB3A: G***; kibuzzard-688CCB3A
kibuzzard-688CCB7A: G***; kibuzzard-688CCB7A
kibuzzard-688CCB16: G***; kibuzzard-688CCB16
kibuzzard-688CCB53: G***; kibuzzard-688CCB53
kibuzzard-688CCBAC: G***; kibuzzard-688CCBAC
kibuzzard-688CCBBF: G***; kibuzzard-688CCBBF
kibuzzard-688CCBE1: G***; kibuzzard-688CCBE1
kibuzzard-688CCBE6: G***; kibuzzard-688CCBE6
