arfrie22/OpenSprinkler-Hardware/OS/4.0/OpenSprinkler4.0/OpenSprinkler4.0.kicad_pcb

## KiCad design OS/4.0/OpenSprinkler4.0/OpenSprinkler4.0.kicad_pcb (2024-08-12)

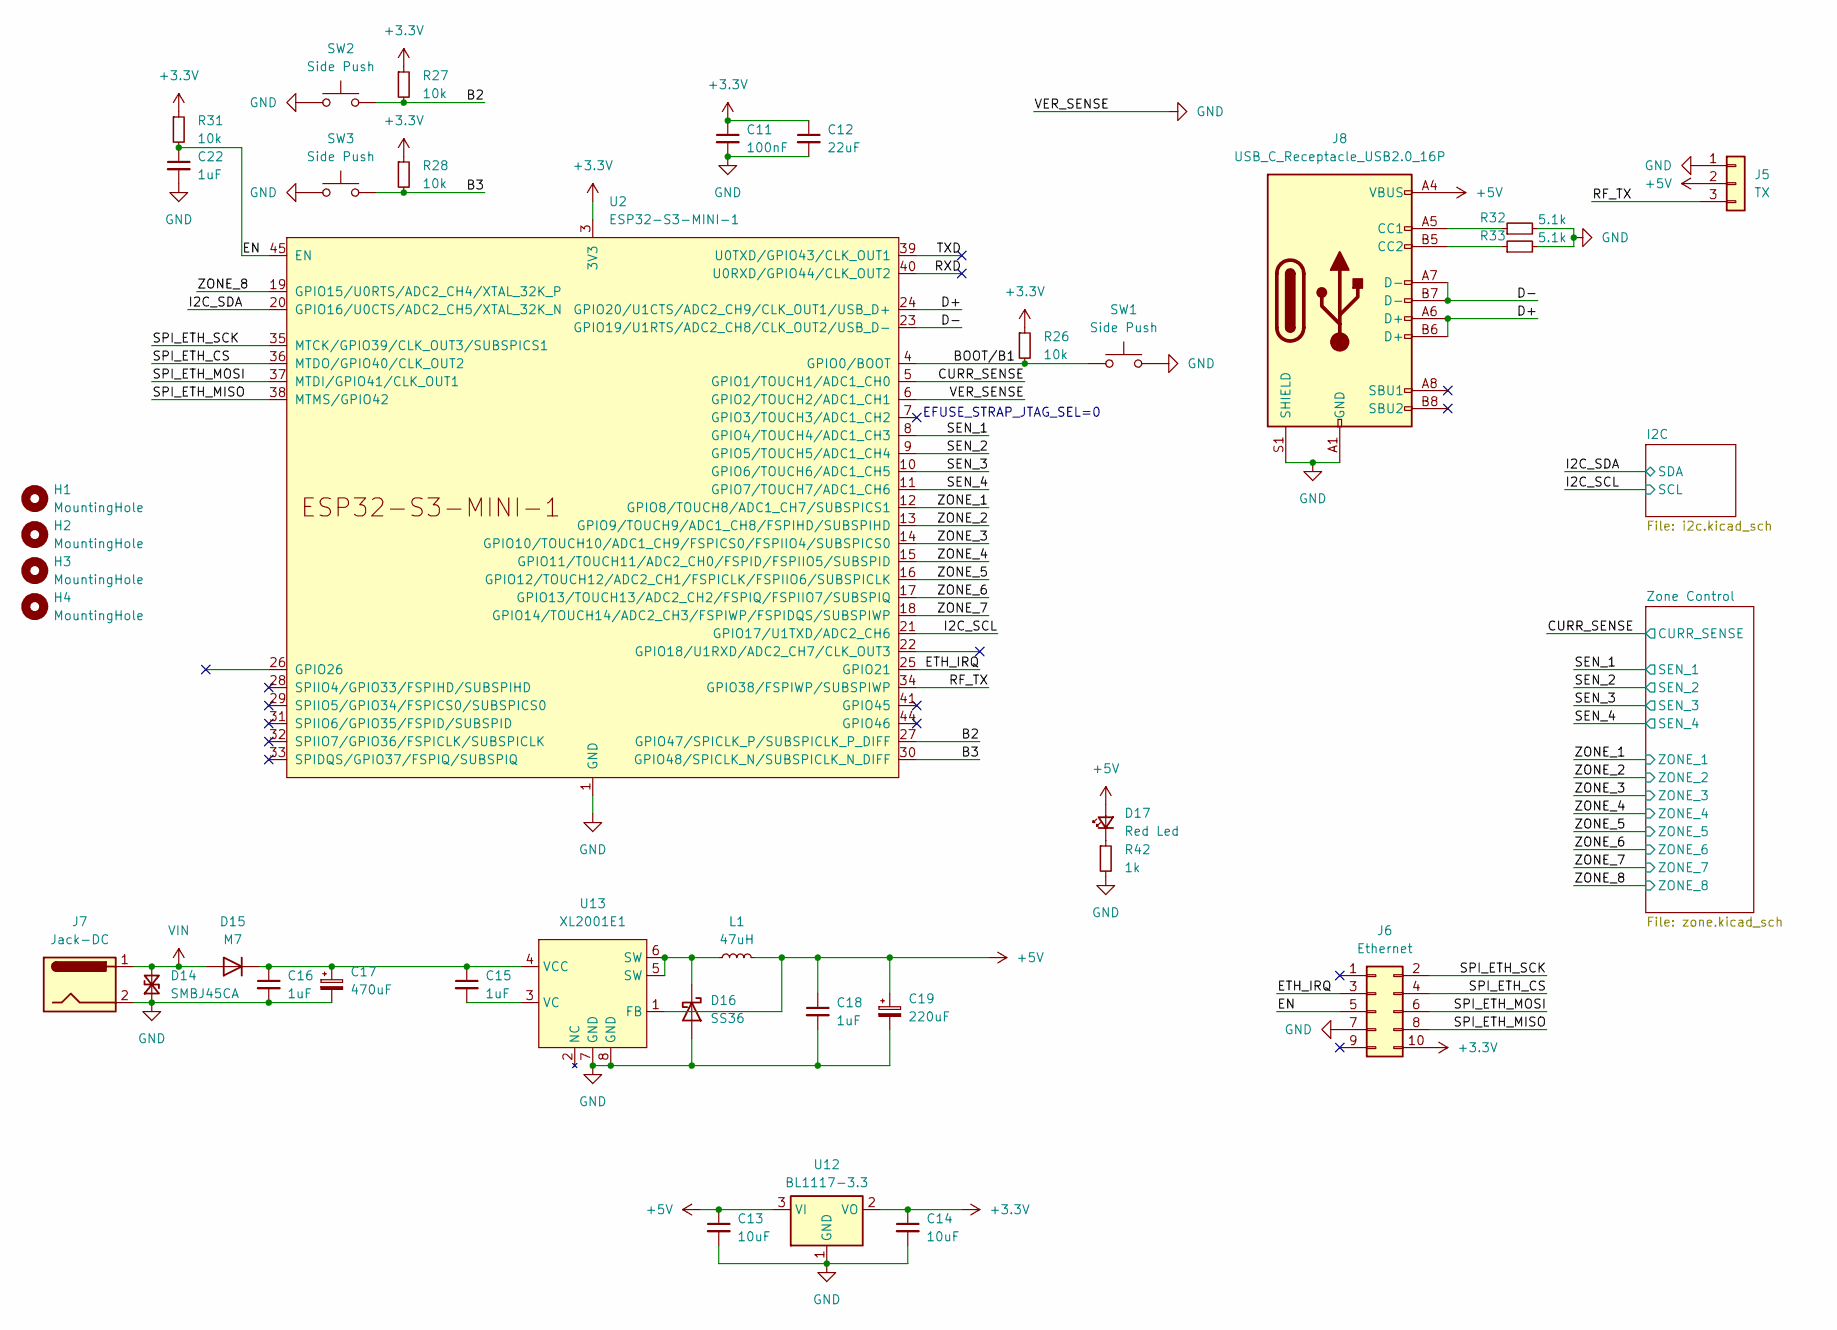
[picture p13: schematic OpenSprinkler4.0.kicad_sch]

Parts:
C11: 100nF; C_0603_1608Metric_Pad1.08x0.95mm_HandSolder; JLCPCB Part # C14663
C12: 22uF; C_0805_2012Metric_Pad1.18x1.45mm_HandSolder; JLCPCB Part # C45783
C13, C14: 10uF; C_0603_1608Metric_Pad1.08x0.95mm_HandSolder; JLCPCB Part # C96446
C15, C16, C18, C22: 1uF; C_0603_1608Metric_Pad1.08x0.95mm_HandSolder; JLCPCB Part # C15849
C17: 470uF; CP_Radial_L20.0mm_D10.0mm_P5.00mm_Horizontal; JLCPCB Part # C2760863
C19: 220uF; CP_Radial_L12.0mm_D8.0mm_P3.50mm_Horizontal; JLCPCB Part # C2831783
D14: SMBJ45CA; D_SMB; JLCPCB Part # C7466424
D15: M7; D_SMA; JLCPCB Part # C7420350
D16: SS36; D_SMA; JLCPCB Part # C7420367
D17: Red Led; LED_0603_1608Metric_Pad1.05x0.95mm_HandSolder; JLCPCB Part # C2286
H1, H2, H3, H4: MountingHole; MountingHole_5.6mm; JLCPCB Part # N/A
J5: TX; PinSocket_1x03_P2.54mm_Horizontal; Part Number 1-0301FBV0T; JLCPCB Part # C2935993
J6: Ethernet; IDC-Header_2x05_P2.54mm_Horizontal; JLCPCB Part # C9140
J7: Jack-DC; BarrelJack_Horizontal; JLCPCB Part # C3010533
J8: USB_C_Receptacle_USB2.0_16P; USB_C_Receptacle_HRO_TYPE-C-31-M-12; JLCPCB Part # C2927038
L1: 47uH; L_Sunlord_MWSA1004S; JLCPCB Part # C182153
R26, R27, R28, R31: 10k; R_0603_1608Metric_Pad0.98x0.95mm_HandSolder; JLCPCB Part # C25804
R32, R33: 5.1k; R_0603_1608Metric_Pad0.98x0.95mm_HandSolder; JLCPCB Part # C23186
R42: 1k; R_0603_1608Metric_Pad0.98x0.95mm_HandSolder; JLCPCB Part # C21190
SW1, SW2, SW3: Side Push; SW_Tactile_SPST_Angled_PTS645Vx83-2LFS; JLCPCB Part # C493059
U2: ESP32-S3-MINI-1; JLCPCB Part # C2913206
U12: BL1117-3.3; SOT-223-3_TabPin2; JLCPCB Part # C5400
U13: XL2001E1; SOP-8_3.9x4.9mm_P1.27mm; JLCPCB Part # C73336

Connections:
+3.3V: C11.1, C12.1, C14.1, J6.10, R26.1, R27.1, R28.1, R31.1, U2.3 (3V3), U12.2 (VO); also elsewhere on the board
+5V: C13.1, C18.1, C19.1, D17.2 (A), J5.2, J8.A4 (VBUS), J8.A9 (VBUS), J8.B4 (VBUS), J8.B9 (VBUS), L1.2, U12.3 (VI), U13.1 (FB); also elsewhere on the board
/B2: R27.2, SW2.1, U2.27 (GPIO47/SPICLK_P/SUBSPICLK_P_DIFF)
/B3: R28.2, SW3.1, U2.30 (GPIO48/SPICLK_N/SUBSPICLK_N_DIFF)
/BOOT/B1: R26.2, SW1.1, U2.4 (GPIO0/BOOT)
/CURR_SENSE: U2.5 (GPIO1/TOUCH1/ADC1_CH0); also elsewhere on the board
/D+: J8.A6 (D+), J8.B6 (D+), U2.24 (GPIO20/U1CTS/ADC2_CH9/CLK_OUT1/USB_D+)
/D-: J8.A7 (D-), J8.B7 (D-), U2.23 (GPIO19/U1RTS/ADC2_CH8/CLK_OUT2/USB_D-)
/EN: C22.1, J6.5, R31.2, U2.45 (EN)
/ETH_IRQ: J6.3, U2.25 (GPIO21)
/I2C_SCL: U2.21 (GPIO17/U1TXD/ADC2_CH6); also elsewhere on the board
/I2C_SDA: U2.20 (GPIO16/U0CTS/ADC2_CH5/XTAL_32K_N); also elsewhere on the board
/RF_TX: J5.3, U2.34 (GPIO38/FSPIWP/SUBSPIWP)
/RXD: U2.40 (U0RXD/GPIO44/CLK_OUT2)
/SEN_1: U2.8 (GPIO4/TOUCH4/ADC1_CH3); also elsewhere on the board
/SEN_2: U2.9 (GPIO5/TOUCH5/ADC1_CH4); also elsewhere on the board
/SEN_3: U2.10 (GPIO6/TOUCH6/ADC1_CH5); also elsewhere on the board
/SEN_4: U2.11 (GPIO7/TOUCH7/ADC1_CH6); also elsewhere on the board
/SPI_ETH_CS: J6.4, U2.36 (MTDO/GPIO40/CLK_OUT2)
/SPI_ETH_MISO: J6.8, U2.38 (MTMS/GPIO42)
/SPI_ETH_MOSI: J6.6, U2.37 (MTDI/GPIO41/CLK_OUT1)
/SPI_ETH_SCK: J6.2, U2.35 (MTCK/GPIO39/CLK_OUT3/SUBSPICS1)
/TXD: U2.39 (U0TXD/GPIO43/CLK_OUT1)
/ZONE_1: U2.12 (GPIO8/TOUCH8/ADC1_CH7/SUBSPICS1); also elsewhere on the board
/ZONE_2: U2.13 (GPIO9/TOUCH9/ADC1_CH8/FSPIHD/SUBSPIHD); also elsewhere on the board
/ZONE_3: U2.14 (GPIO10/TOUCH10/ADC1_CH9/FSPICS0/FSPIIO4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); also elsewhere on the board
/ZONE_4: U2.15 (GPIO11/TOUCH11/ADC2_CH0/FSPID/FSPIIO5/S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); also elsewhere on the board
/ZONE_5: U2.16 (GPIO12/TOUCH12/ADC2_CH1/FSPICLK/FSPIIO6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); also elsewhere on the board
/ZONE_6: U2.17 (GPIO13/TOUCH13/ADC2_CH2/FSPIQ/FSPIIO7/S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); also elsewhere on the board
/ZONE_7: U2.18 (GPIO14/TOUCH14/ADC2_CH3/FSPIWP/FSPIDQS/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); also elsewhere on the board
/ZONE_8: U2.19 (GPIO15/U0RTS/ADC2_CH4/XTAL_32K_P); also elsewhere on the board
GND: C11.2, C12.2, C13.2, C14.2, C16.2, C17.2, C18.2, C19.2, C22.2, D14.1 (A1), D16.2 (A), J5.1, J6.7, J7.2, J8.A1 (GND), J8.A12 (GND), J8.B1 (GND), J8.B12 (GND), J8.S1 (SHIELD), R32.2, R33.2, R42.2, SW1.2, SW2.2, SW3.2, U2.1 (GND), U2.2 (GND), U2.6 (GPIO2/TOUCH2/ADC1_CH1), U2.42 (GND), U2.43 (GND), U2.46 (GND), U2.47 (GND), U2.48 (GND), U2.49 (GND), U2.50 (GND), U2.51 (GND), U2.52 (GND), U2.53 (GND), U2.54 (GND), U2.55 (GND), U2.56 (GND), U2.57 (GND), U2.58 (GND), U2.59 (GND), U2.60 (GND), U2.61 (GND), U2.62 (GND), U2.63 (GND), U2.64 (GND), U2.65 (GND), U12.1 (GND), U13.7 (GND), U13.8 (GND); also elsewhere on the board
unnamed: C15.1, C16.1, C17.1, D15.1 (K), U13.4 (VCC)
unnamed: D16.1 (K), L1.1, U13.5 (SW), U13.6 (SW)
unnamed: D17.1 (K), R42.1
unnamed: J8.A5 (CC1), R32.1
unnamed: J8.B5 (CC2), R33.1
unnamed: C15.2, U13.3 (VC)
VIN: D14.2 (A2), D15.2 (A), J7.1; also elsewhere on the board

Notes on the sheet:
EFUSE_STRAP_JTAG_SEL=0

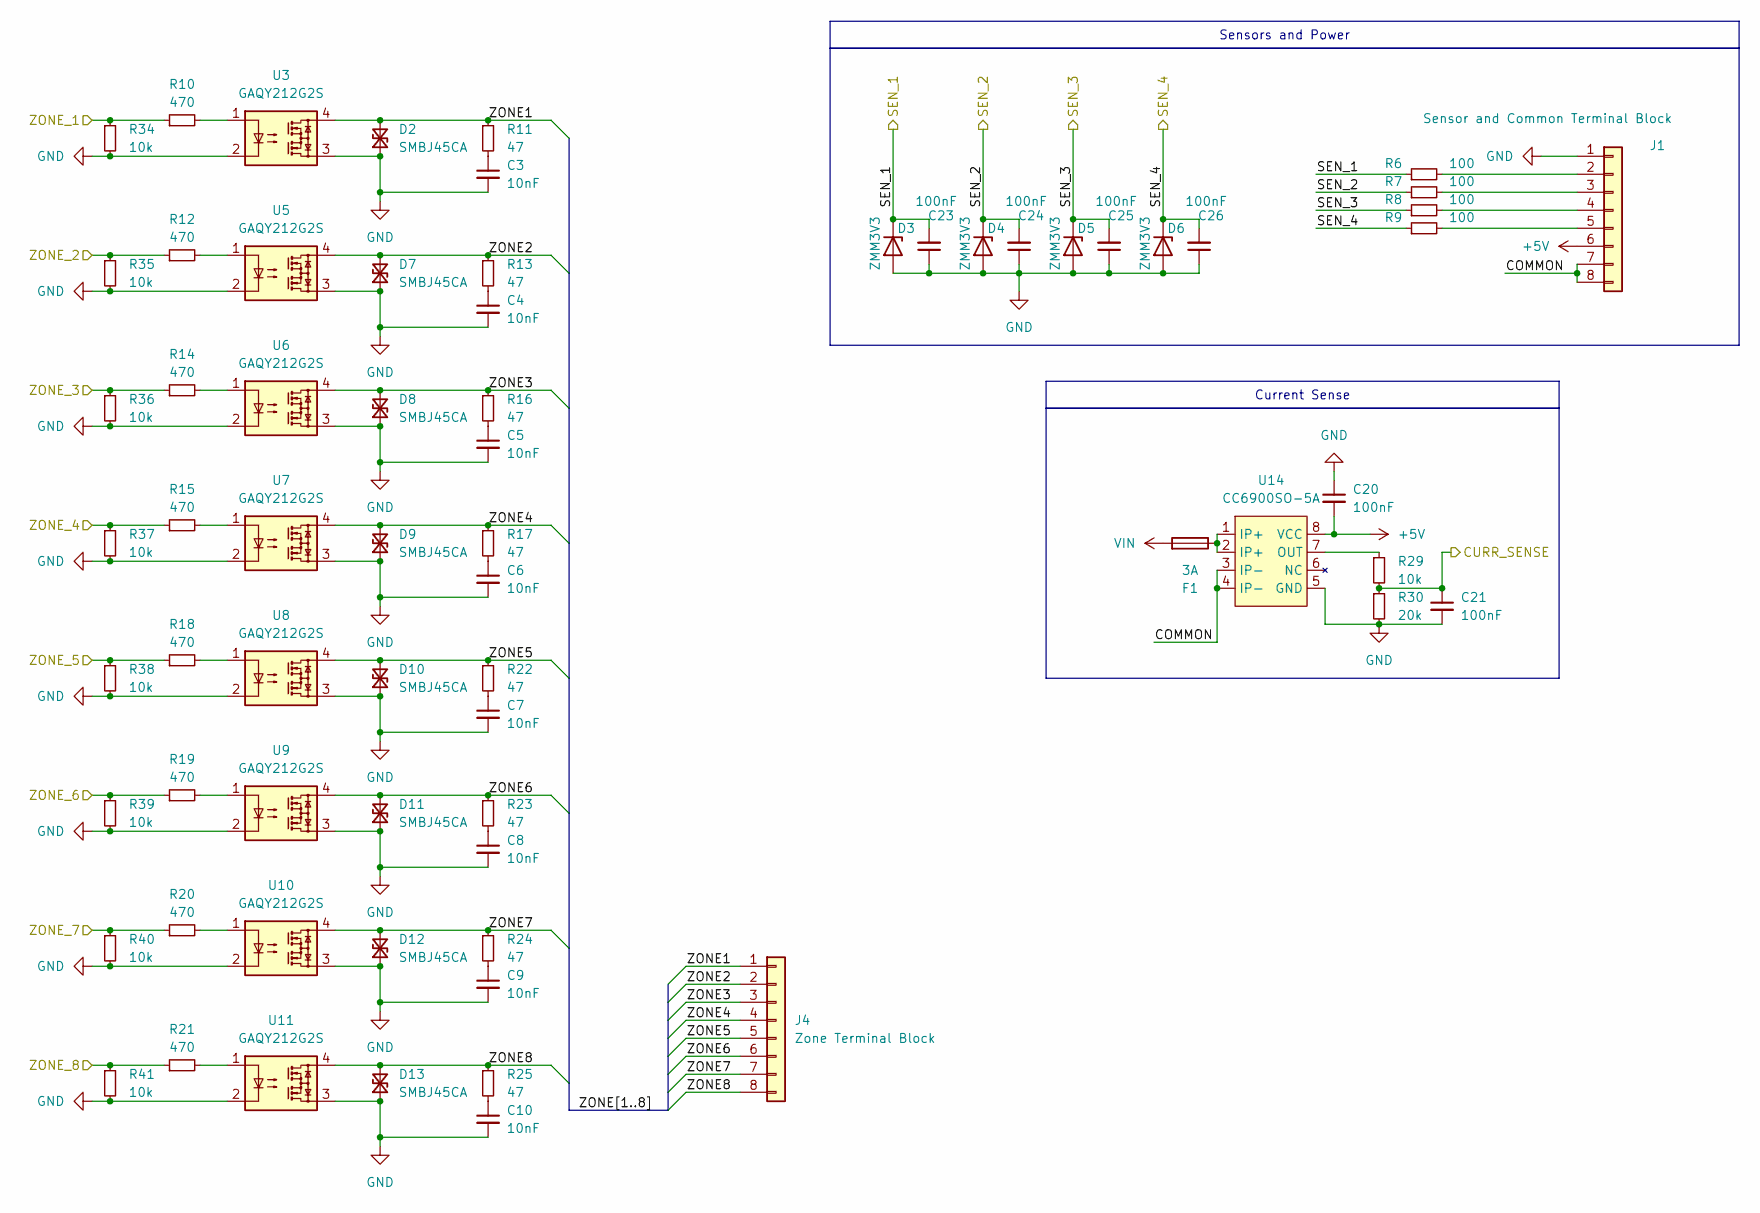
[picture p14: schematic zone.kicad_sch]

Parts:
C3, C4, C5, C6, C7, C8, C9, C10: 10nF; C_0603_1608Metric_Pad1.08x0.95mm_HandSolder; JLCPCB Part # C57112
C20, C21: 100nF; C_0603_1608Metric_Pad1.08x0.95mm_HandSolder; JLCPCB Part # C14663
C23, C24, C25, C26: 100nF; C_0603_1608Metric_Pad1.08x0.95mm_HandSolder
D2, D7, D8, D9, D10, D11, D12, D13: SMBJ45CA; D_SMB; JLCPCB Part # C7466424
D3, D4, D5, D6: ZMM3V3; D_MiniMELF; JLCPCB Part # C7497475
F1: 3A; Xucheng_Elec_5x20; JLCPCB Part # C3130
J1: Sensor and Common Terminal Block; Samtec_HPM-08-05-x-S_Straight_1x08_Pitch5.08mm; JLCPCB Part # C31423
J4: Zone Terminal Block; Samtec_HPM-08-05-x-S_Straight_1x08_Pitch5.08mm; JLCPCB Part # C31423
R6, R7, R8, R9: 100; R_0603_1608Metric_Pad0.98x0.95mm_HandSolder; JLCPCB Part # C22775
R10, R12, R14, R15, R18, R19, R20, R21: 470; R_0603_1608Metric_Pad0.98x0.95mm_HandSolder; JLCPCB Part # C23179
R11, R13, R16, R17, R22, R23, R24, R25: 47; R_0603_1608Metric_Pad0.98x0.95mm_HandSolder; JLCPCB Part # C23182
R29, R34, R35, R36, R37, R38, R39, R40, R41: 10k; R_0603_1608Metric_Pad0.98x0.95mm_HandSolder; JLCPCB Part # C25804
R30: 20k; R_0603_1608Metric_Pad0.98x0.95mm_HandSolder; JLCPCB Part # C4184
U3, U5, U6, U7, U8, U9, U10, U11: GAQY212G2S; SOP-4_3.8x4.1mm_P2.54mm; JLCPCB Part # C7435109
U14: CC6900SO-5A; SOP-8_3.9x4.9mm_P1.27mm; JLCPCB Part # C350864

Connections:
+5V: C20.2, J1.6, U14.8 (VCC); also elsewhere on the board
/CURR_SENSE: C21.1, R29.2, R30.1; also elsewhere on the board
/SEN_1: C23.2, D3.1 (K), R6.1; also elsewhere on the board
/SEN_2: C24.2, D4.1 (K), R7.1; also elsewhere on the board
/SEN_3: C25.2, D5.1 (K), R8.1; also elsewhere on the board
/SEN_4: C26.2, D6.1 (K), R9.1; also elsewhere on the board
/ZONE_1: R10.1, R34.1; also elsewhere on the board
/ZONE_2: R12.1, R35.1; also elsewhere on the board
/ZONE_3: R14.1, R36.1; also elsewhere on the board
/ZONE_4: R15.1, R37.1; also elsewhere on the board
/ZONE_5: R18.1, R38.1; also elsewhere on the board
/ZONE_6: R19.1, R39.1; also elsewhere on the board
/ZONE_7: R20.1, R40.1; also elsewhere on the board
/ZONE_8: R21.1, R41.1; also elsewhere on the board
/Zone Control/COMMON: J1.7, J1.8, U14.3 (IP-), U14.4 (IP-)
/Zone Control/ZONE1: D2.2 (A2), J4.1, R11.1, U3.4
/Zone Control/ZONE2: D7.2 (A2), J4.2, R13.1, U5.4
/Zone Control/ZONE3: D8.2 (A2), J4.3, R16.1, U6.4
/Zone Control/ZONE4: D9.2 (A2), J4.4, R17.1, U7.4
/Zone Control/ZONE5: D10.2 (A2), J4.5, R22.1, U8.4
/Zone Control/ZONE6: D11.2 (A2), J4.6, R23.1, U9.4
/Zone Control/ZONE7: D12.2 (A2), J4.7, R24.1, U10.4
/Zone Control/ZONE8: D13.2 (A2), J4.8, R25.1, U11.4
GND: C3.2, C4.2, C5.2, C6.2, C7.2, C8.2, C9.2, C10.2, C20.1, C21.2, C23.1, C24.1, C25.1, C26.1, D2.1 (A1), D3.2 (A), D4.2 (A), D5.2 (A), D6.2 (A), D7.1 (A1), D8.1 (A1), D9.1 (A1), D10.1 (A1), D11.1 (A1), D12.1 (A1), D13.1 (A1), J1.1, R30.2, R34.2, R35.2, R36.2, R37.2, R38.2, R39.2, R40.2, R41.2, U3.2, U3.3, U5.2, U5.3, U6.2, U6.3, U7.2, U7.3, U8.2, U8.3, U9.2, U9.3, U10.2, U10.3, U11.2, U11.3, U14.5 (GND); also elsewhere on the board
unnamed: C3.1, R11.2
unnamed: C4.1, R13.2
unnamed: C5.1, R16.2
unnamed: C6.1, R17.2
unnamed: C7.1, R22.2
unnamed: C8.1, R23.2
unnamed: C9.1, R24.2
unnamed: C10.1, R25.2
unnamed: F1.1, U14.1 (IP+), U14.2 (IP+)
unnamed: J1.2, R6.2
unnamed: J1.3, R7.2
unnamed: J1.4, R8.2
unnamed: J1.5, R9.2
unnamed: R10.2, U3.1
unnamed: R12.2, U5.1
unnamed: R14.2, U6.1
unnamed: R15.2, U7.1
unnamed: R18.2, U8.1
unnamed: R19.2, U9.1
unnamed: R20.2, U10.1
unnamed: R21.2, U11.1
unnamed: R29.1, U14.7 (OUT)
VIN: F1.2; also elsewhere on the board

Notes on the sheet:
Sensors and Power
Current Sense

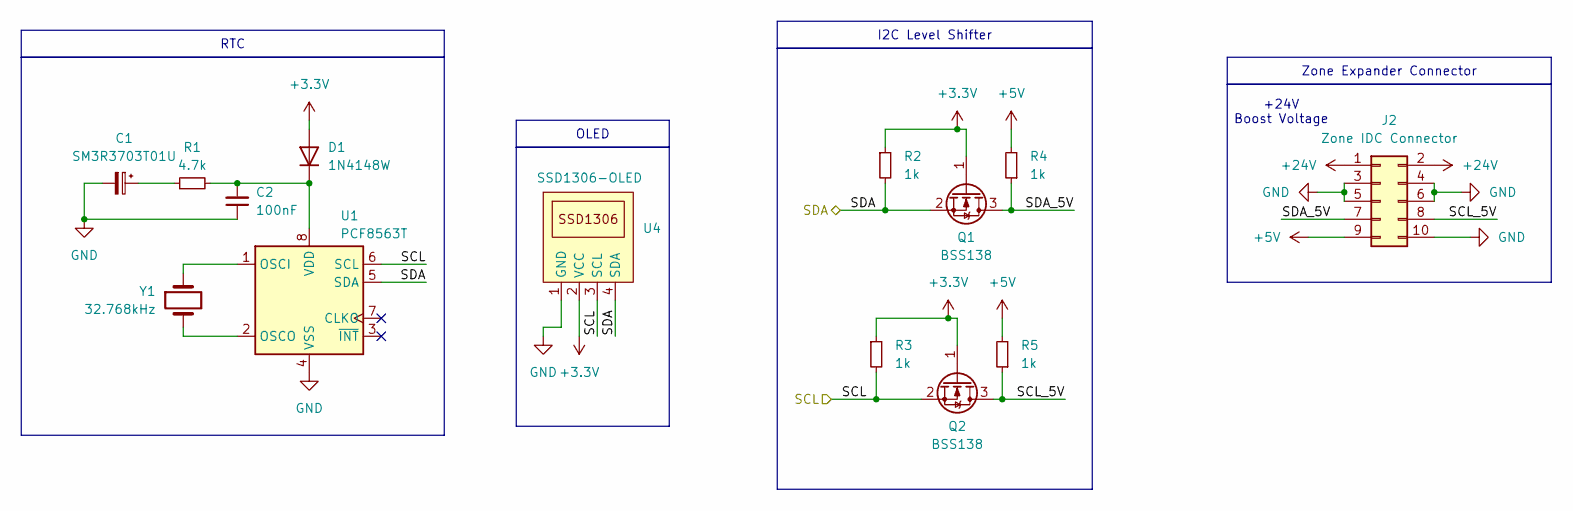
[picture p15: schematic i2c.kicad_sch]

Parts:
C1: SM3R3703T01U; SM3R3703T01; JLCPCB Part # C396469
C2: 100nF; C_0603_1608Metric_Pad1.08x0.95mm_HandSolder; JLCPCB Part # C14663
D1: 1N4148W; D_SOD-123; JLCPCB Part # C81598
J2: Zone IDC Connector; IDC-Header_2x05_P2.54mm_Horizontal; JLCPCB Part # C9140
Q1, Q2: BSS138; SOT-23; JLCPCB Part # C7420339
R1: 4.7k; R_0603_1608Metric_Pad0.98x0.95mm_HandSolder; JLCPCB Part # C23162
R2, R3, R4, R5: 1k; R_0603_1608Metric_Pad0.98x0.95mm_HandSolder; JLCPCB Part # C21190
U1: PCF8563T; SOIC-8_3.9x4.9mm_P1.27mm; JLCPCB Part # C7440
U4: SSD1306-OLED; JMD0.96D-1; JLCPCB Part # C2935975
Y1: 32.768kHz; Crystal_DS26_D2.0mm_L6.0mm_Horizontal; JLCPCB Part # C145163

Connections:
+3.3V: D1.2 (A), Q1.1 (G), Q2.1 (G), R2.1, R3.1, U4.2 (VCC); also elsewhere on the board
+5V: J2.9, R4.2, R5.2; also elsewhere on the board
+24V: J2.1, J2.2
/I2C/SCL_5V: J2.8, Q2.3 (D), R5.1
/I2C/SDA_5V: J2.7, Q1.3 (D), R4.1
/I2C_SCL: Q2.2 (S), R3.2, U1.6 (SCL), U4.3 (SCL); also elsewhere on the board
/I2C_SDA: Q1.2 (S), R2.2, U1.5 (SDA), U4.4 (SDA); also elsewhere on the board
GND: C1.2, C2.1, J2.3, J2.4, J2.5, J2.6, J2.10, U1.4 (VSS), U4.1 (GND); also elsewhere on the board
unnamed: C1.1, R1.1
unnamed: C2.2, D1.1 (K), R1.2, U1.8 (VDD)
unnamed: U1.1 (OSCI), Y1.1
unnamed: U1.2 (OSCO), Y1.2

Notes on the sheet:
OLED
Zone Expander Connector
I2C Level Shifter
RTC
+24V Boost Voltage

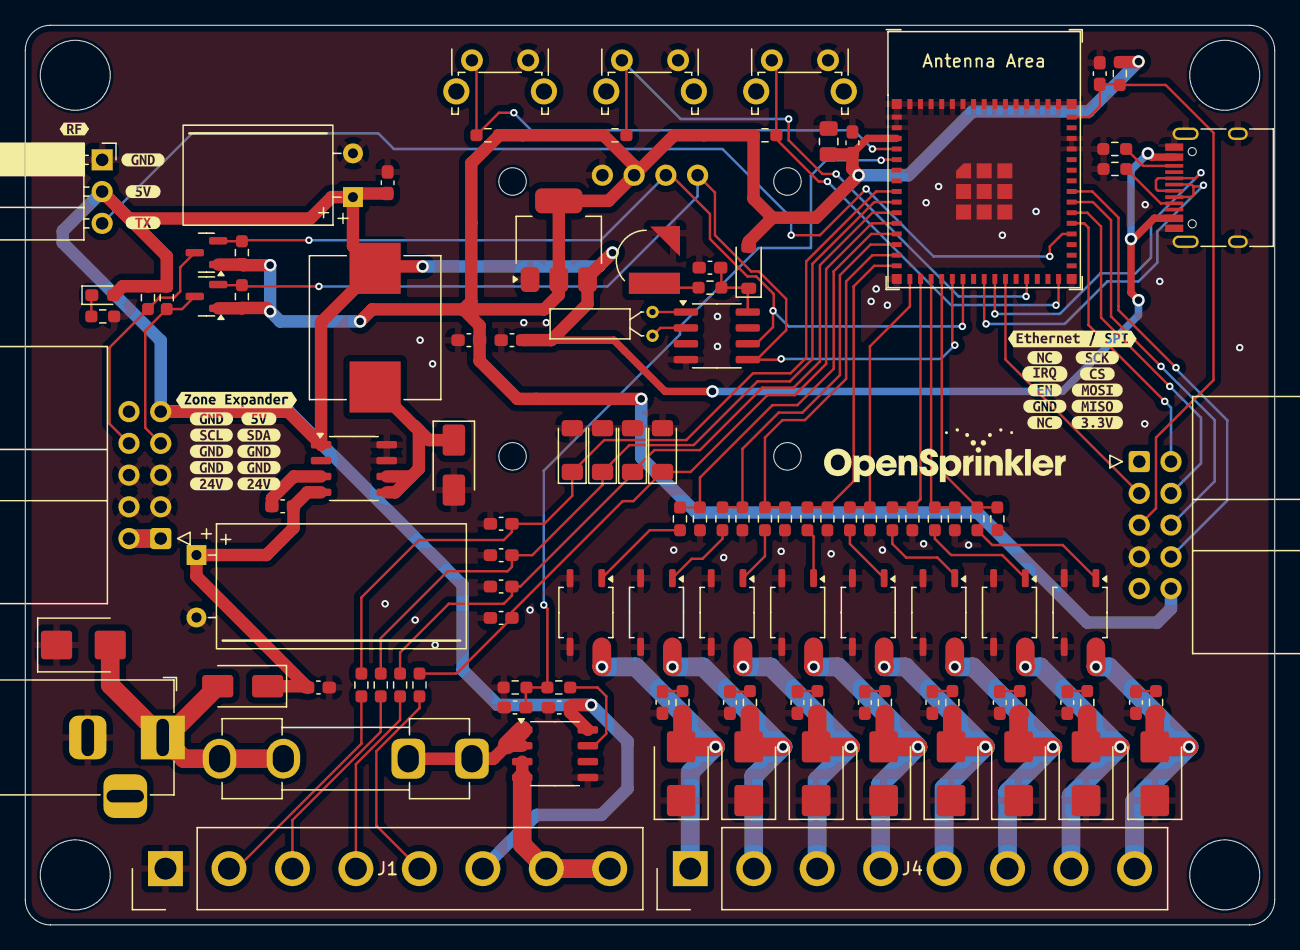
[picture p16: board OpenSprinkler4.0.kicad_pcb from above]

Board: 2 copper layers, 100.0 x 72.0 mm, 144 parts (0 on the bottom side), 75 nets.

Other parts of the board:
kibuzzard-66A7F7F7: G***; kibuzzard-66A7F7F7
kibuzzard-66A7F74C: G***; kibuzzard-66A7F74C
kibuzzard-66A7F75B: G***; kibuzzard-66A7F75B
kibuzzard-66A7F829: G***; kibuzzard-66A7F829
kibuzzard-66A7FD7B: G***; kibuzzard-66A7FD7B
kibuzzard-66A7FD8D: G***; kibuzzard-66A7FD8D
kibuzzard-66A7FD67: G***; kibuzzard-66A7FD67
kibuzzard-66A7FD96: G***; kibuzzard-66A7FD96
kibuzzard-66A7FDEE: G***; kibuzzard-66A7FDEE
kibuzzard-66A7FE28: G***; kibuzzard-66A7FE28
kibuzzard-66A917B8: G***; kibuzzard-66A917B8
kibuzzard-66A950A2: G***; kibuzzard-66A950A2
kibuzzard-66A950A5: G***; kibuzzard-66A950A5
kibuzzard-66A950AB: G***; kibuzzard-66A950AB
kibuzzard-66A9503B: G***; kibuzzard-66A9503B
kibuzzard-66A9503E: G***; kibuzzard-66A9503E
kibuzzard-66A9508D: G***; kibuzzard-66A9508D
kibuzzard-66A9509C: G***; kibuzzard-66A9509C
kibuzzard-66A95035: G***; kibuzzard-66A95035
kibuzzard-66A95039: G***; kibuzzard-66A95039
kibuzzard-66A95040: G***; kibuzzard-66A95040
kibuzzard-66A95080: G***; kibuzzard-66A95080
kibuzzard-66A95085: G***; kibuzzard-66A95085
kibuzzard-66A95089: G***; kibuzzard-66A95089
kibuzzard-66A95092: G***; kibuzzard-66A95092
kibuzzard-66A95097: G***; kibuzzard-66A95097
