arfrie22/OpenSprinkler-Hardware/(commit log)

2024-08-12 opensprinkler 4.0
    [HRO_TYPE-C-31-M-12.step, OpenSprinkler4.0.kicad_pcb, OpenSprinkler4.0.kicad_sch, SUPERCAP_SM3R3703T01.stp, i2c.kicad_sch, zone.kicad_sch]
2025-09-04 new design
    [Network.kicad_sch, OpenSprinkler4.0_DC.kicad_pcb, OpenSprinkler4.0_DC.kicad_sch, RP2350_QFN80.step, zones.kicad_sch]
